Board-Folk/TIM011B2/Expansions/T2.1-VGA-RP2040/README.md

# T2.1-VGA-RP2040

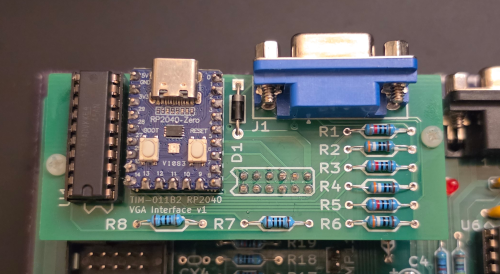
[picture p2: images/t2.1-vga-rp2040_built_small.png]
Image of TIM-011B2 v2.1 VGA Adapter built in Green


VGA Adapter for TIM-011B2 v2.1 using the RP2040 Mini. Code based on RGBI_TO_VGA by Dmitry Tsvetkov can be found on [Marko's fork for the TIM011B2](https://github.com/msolajic/RGBI_TO_VGA).

## Versions

v1 Initial version
