Board-Folk/TIM011B2/Releases/v2.2/README.md

# TIM-011B2 v2.2

04/11/2026

Image of build version 2.2 board in black with mini ps/2 module

Ceramic capacitors 5.08mm and resistors 1/4W.
CPLD and GAL by Marko Šolajić (@msolajic).
