Board-Folk/TIM011B2/Releases/v2.2/cpld/tim011video/timvideo.jpg

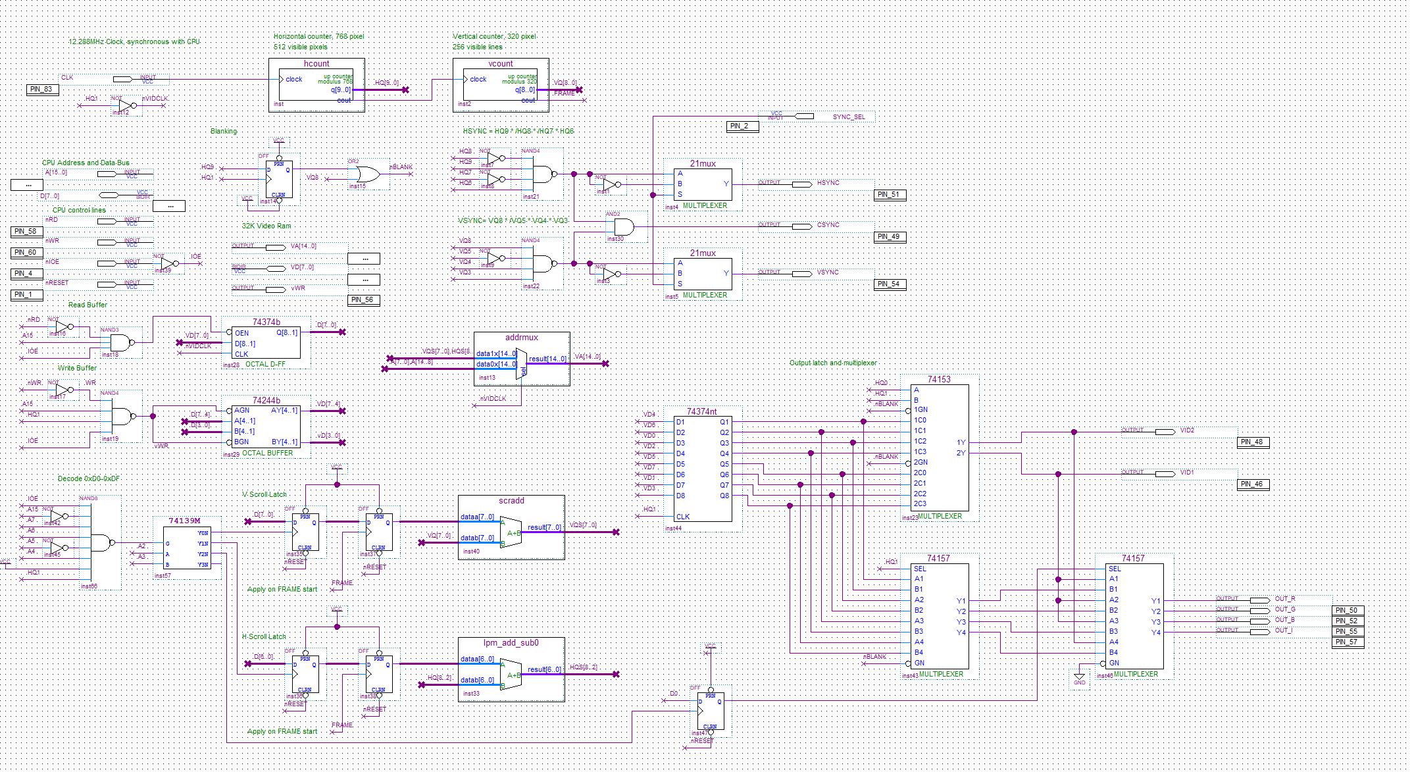
Releases/v2.2/cpld/tim011video/timvideo.jpg
