Board-Folk/TIM011B2/Releases/v2.2/Kicad/TIM-011B2.pdf

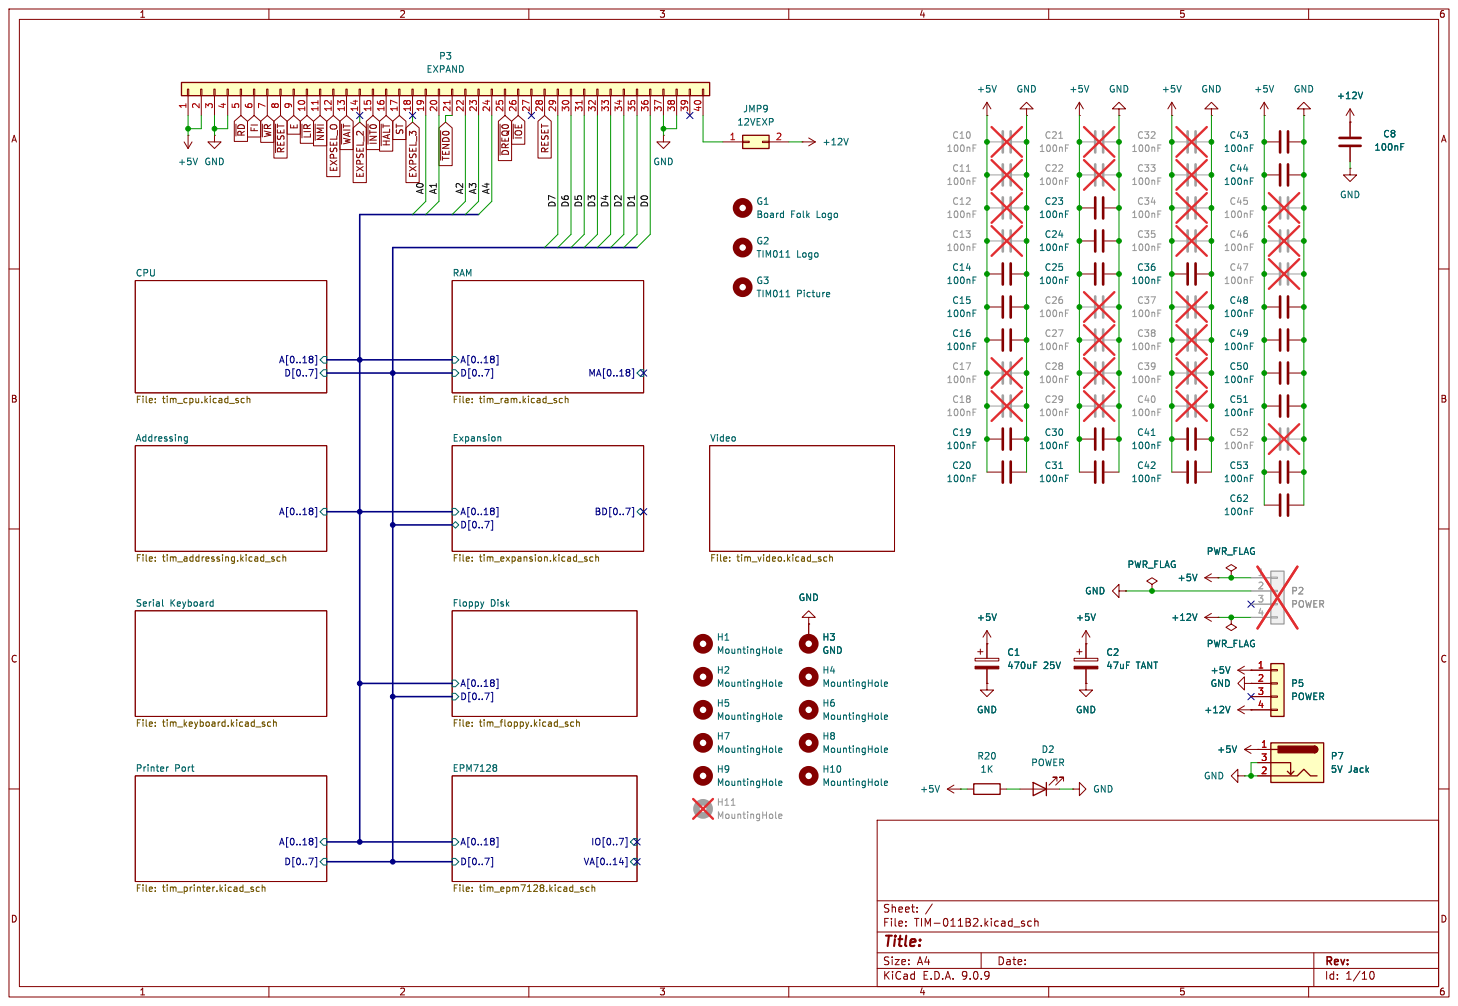
[picture p5: page 1]

100nF G3 TIM011 Picture G1 Board Folk Logo

File: tim_ram.kicad_sch Serial Keyboard File: tim_keyboard.kicad_sch

Id: 1/10 Title: File: TIM-011B2.kicad_sch Sheet: / A[0..18]

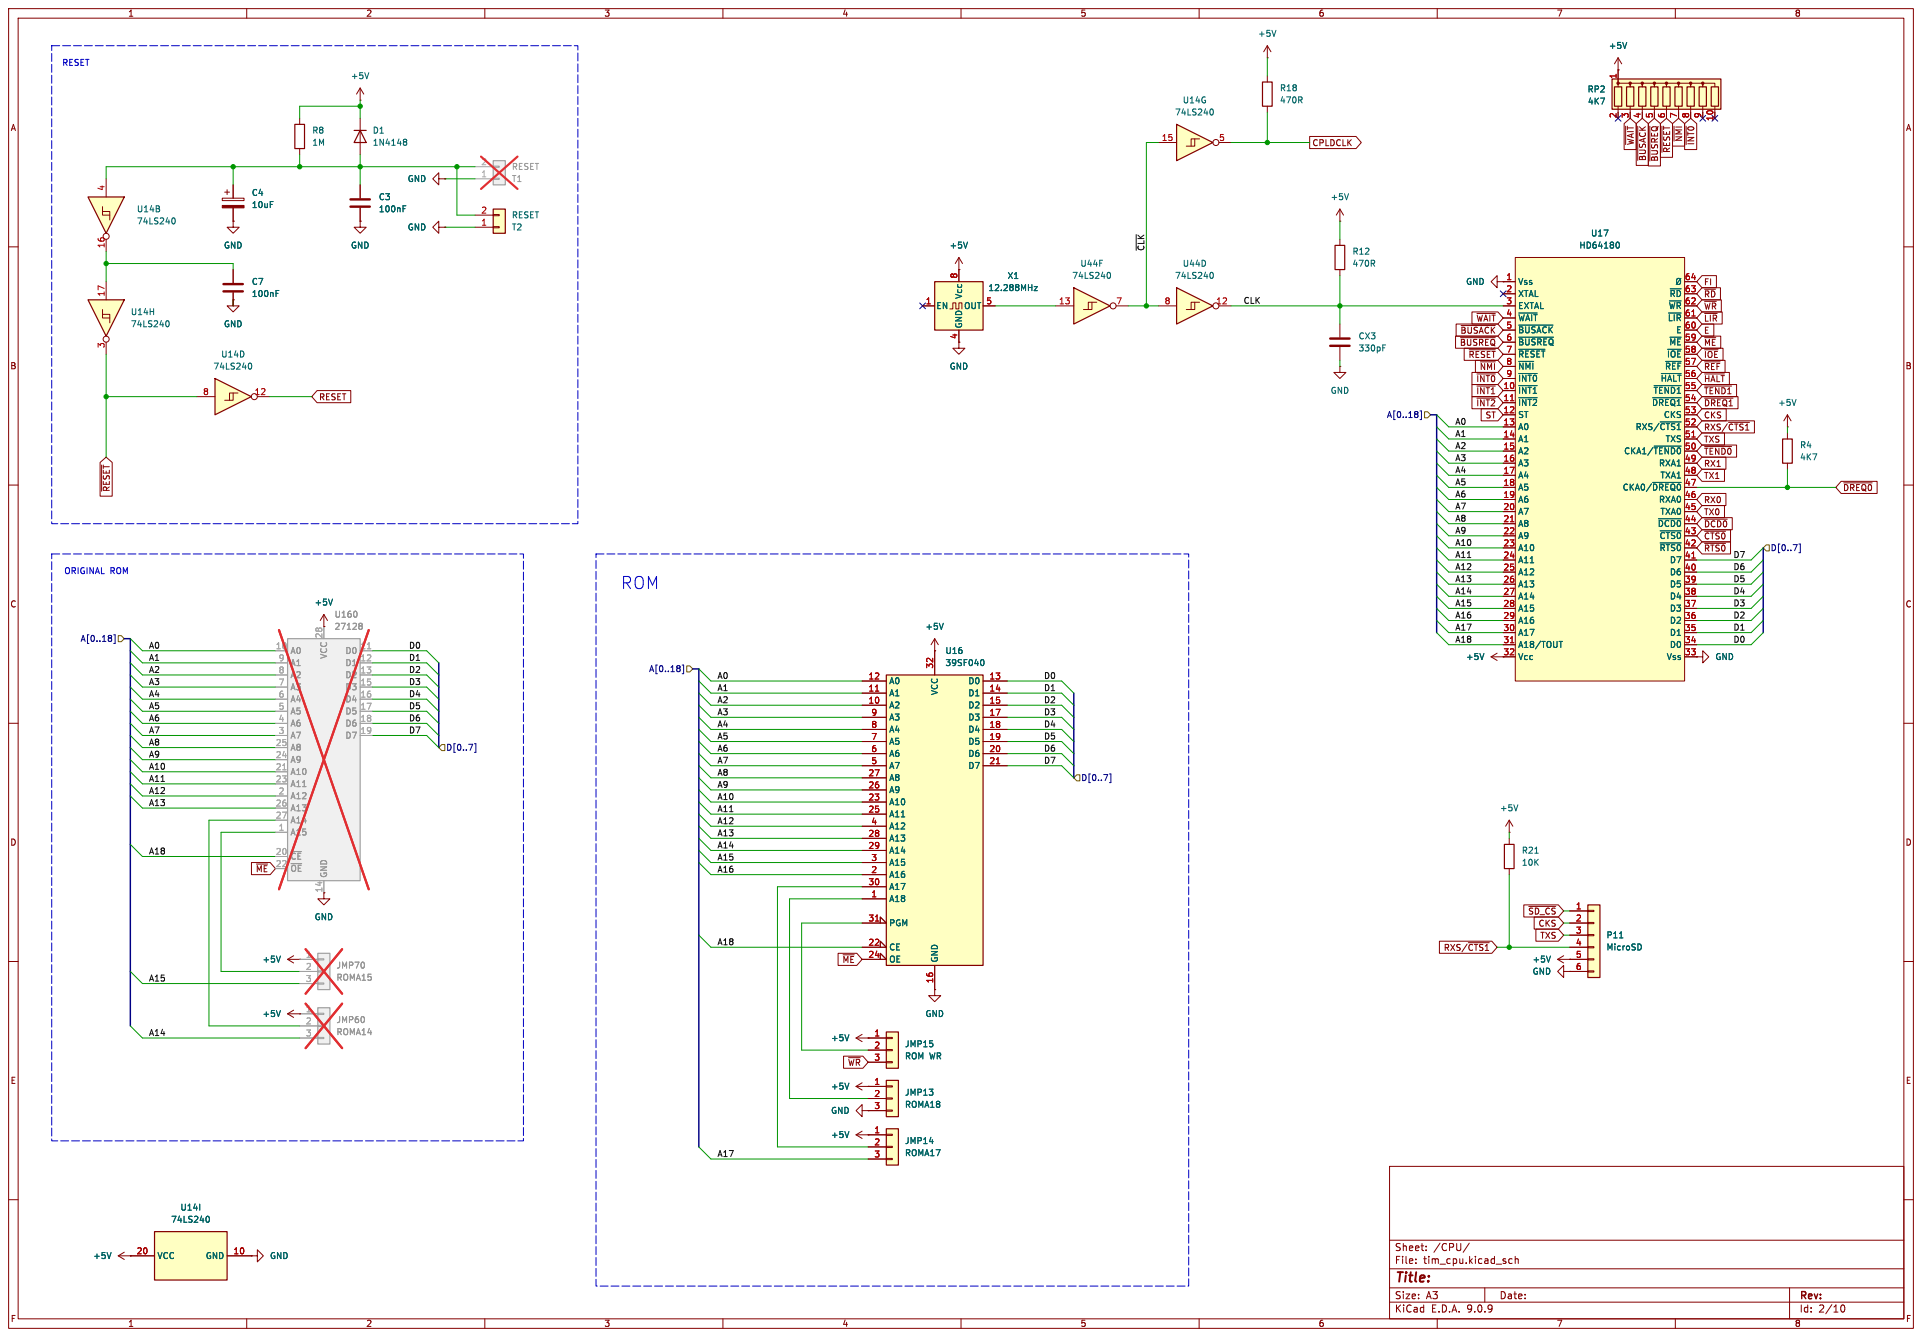
[picture p6: page 2]

64 ~{RD} 63 ~{WR} 62 ~{LIR}61 E
60 ~{ME} 59 ~{IOE} 58 ~{REF} 57 ~{HALT} 56 ~{TEND1}55 ~{DREQ1}54 CKS

Id: 2/10 Title: File: tim_cpu.kicad_sch Sheet: /CPU/ 123

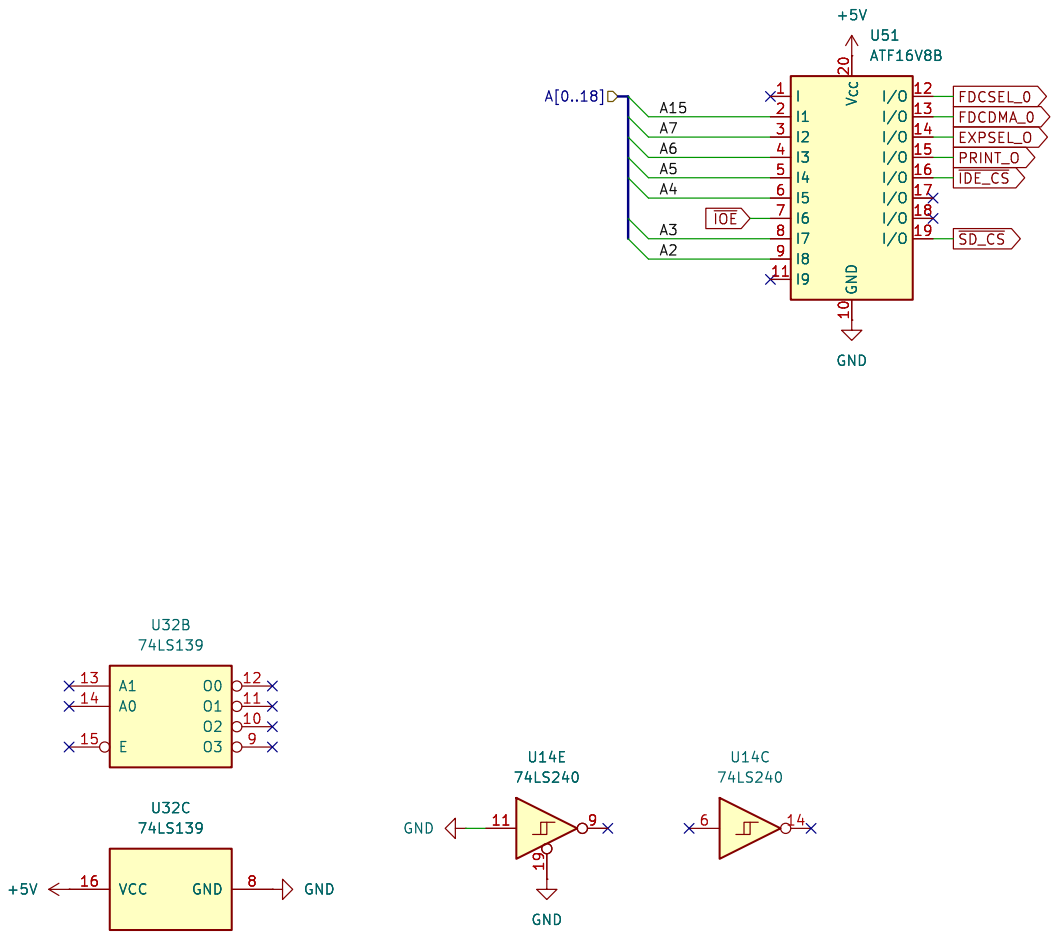
[picture p7: page 3]

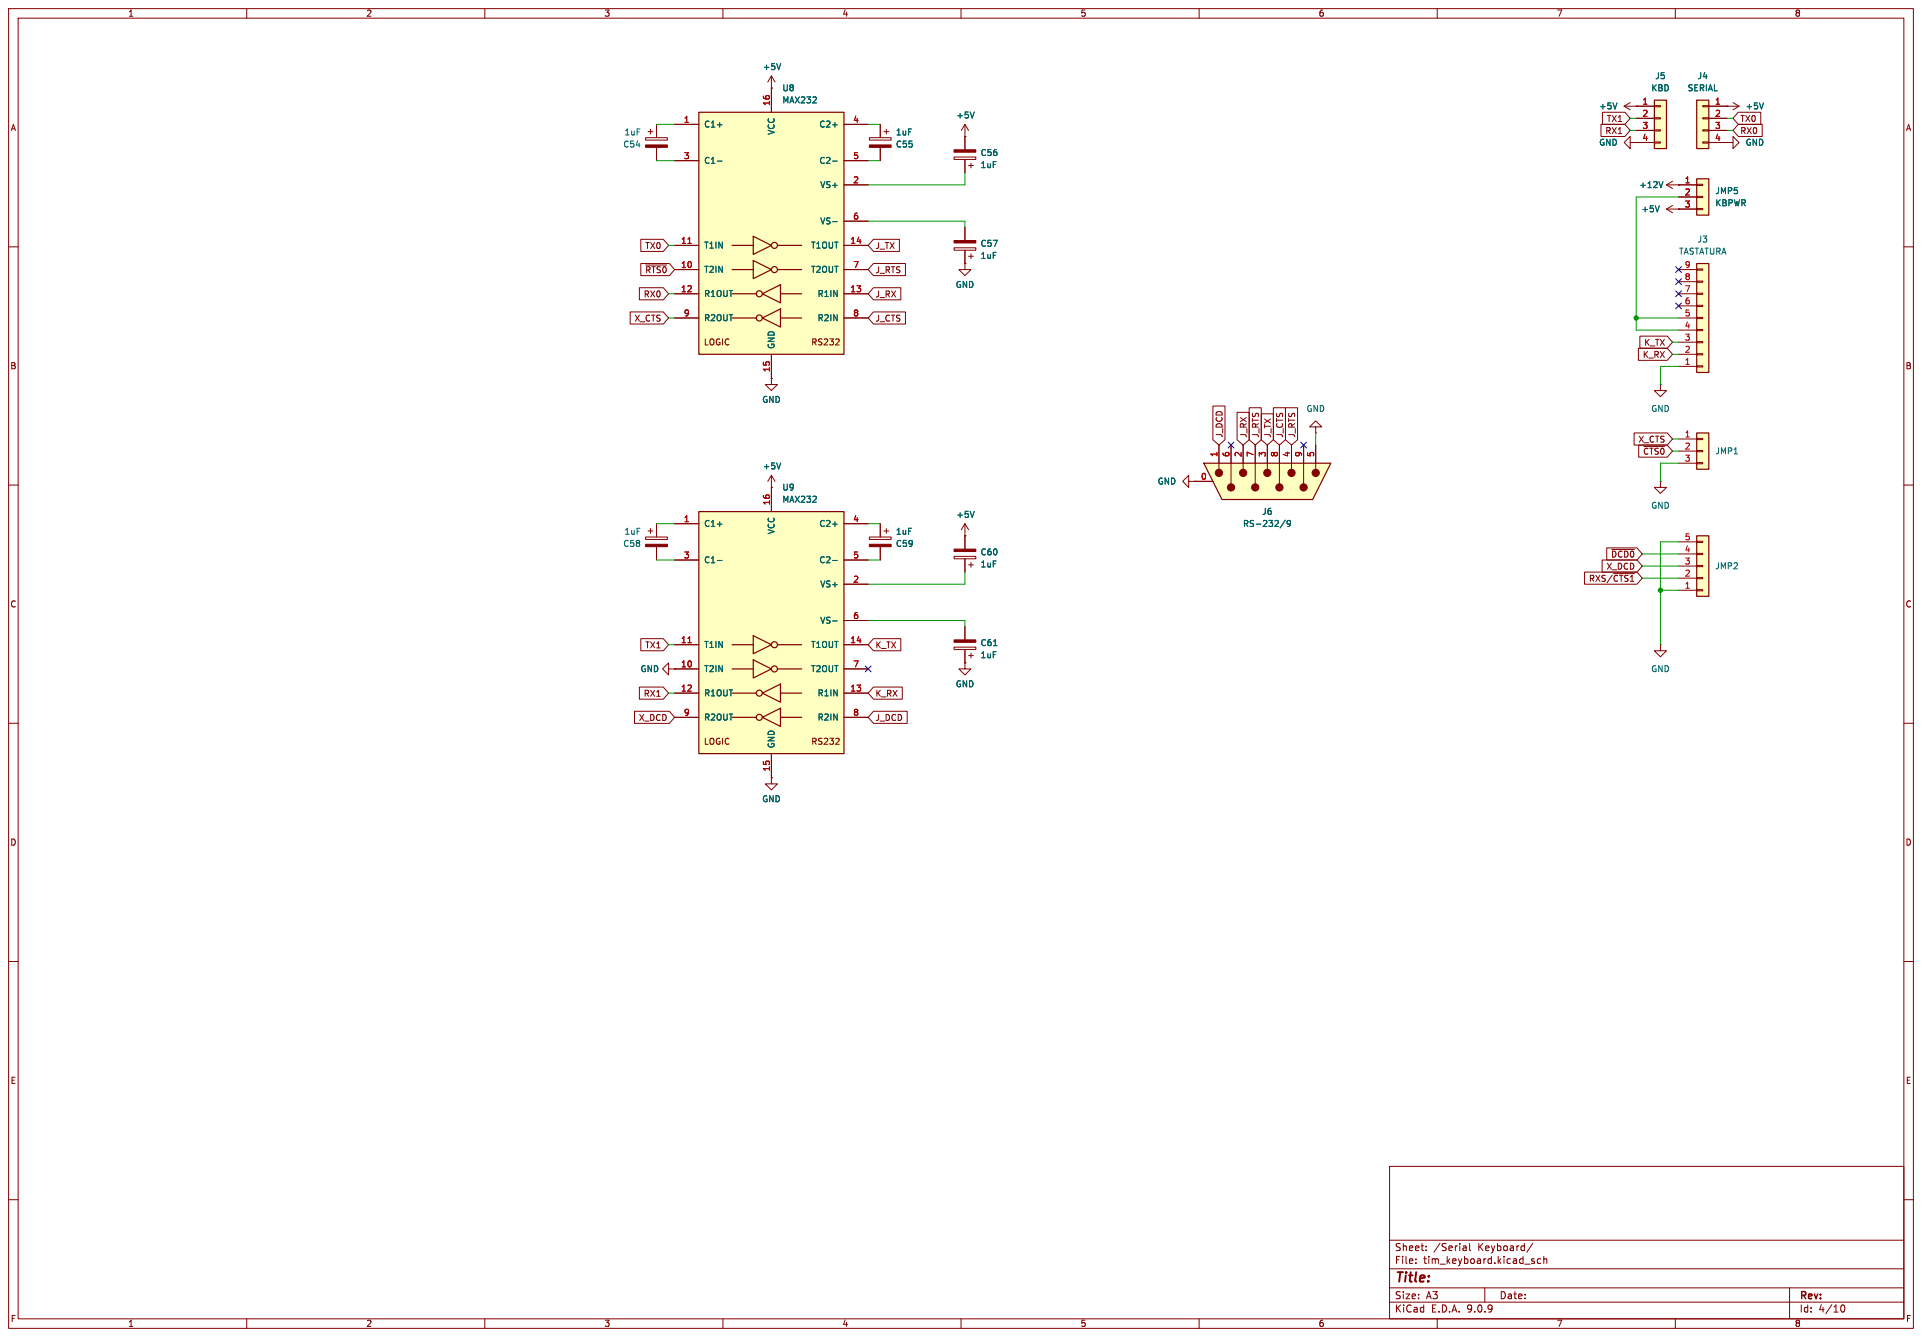
[picture p8: page 4]

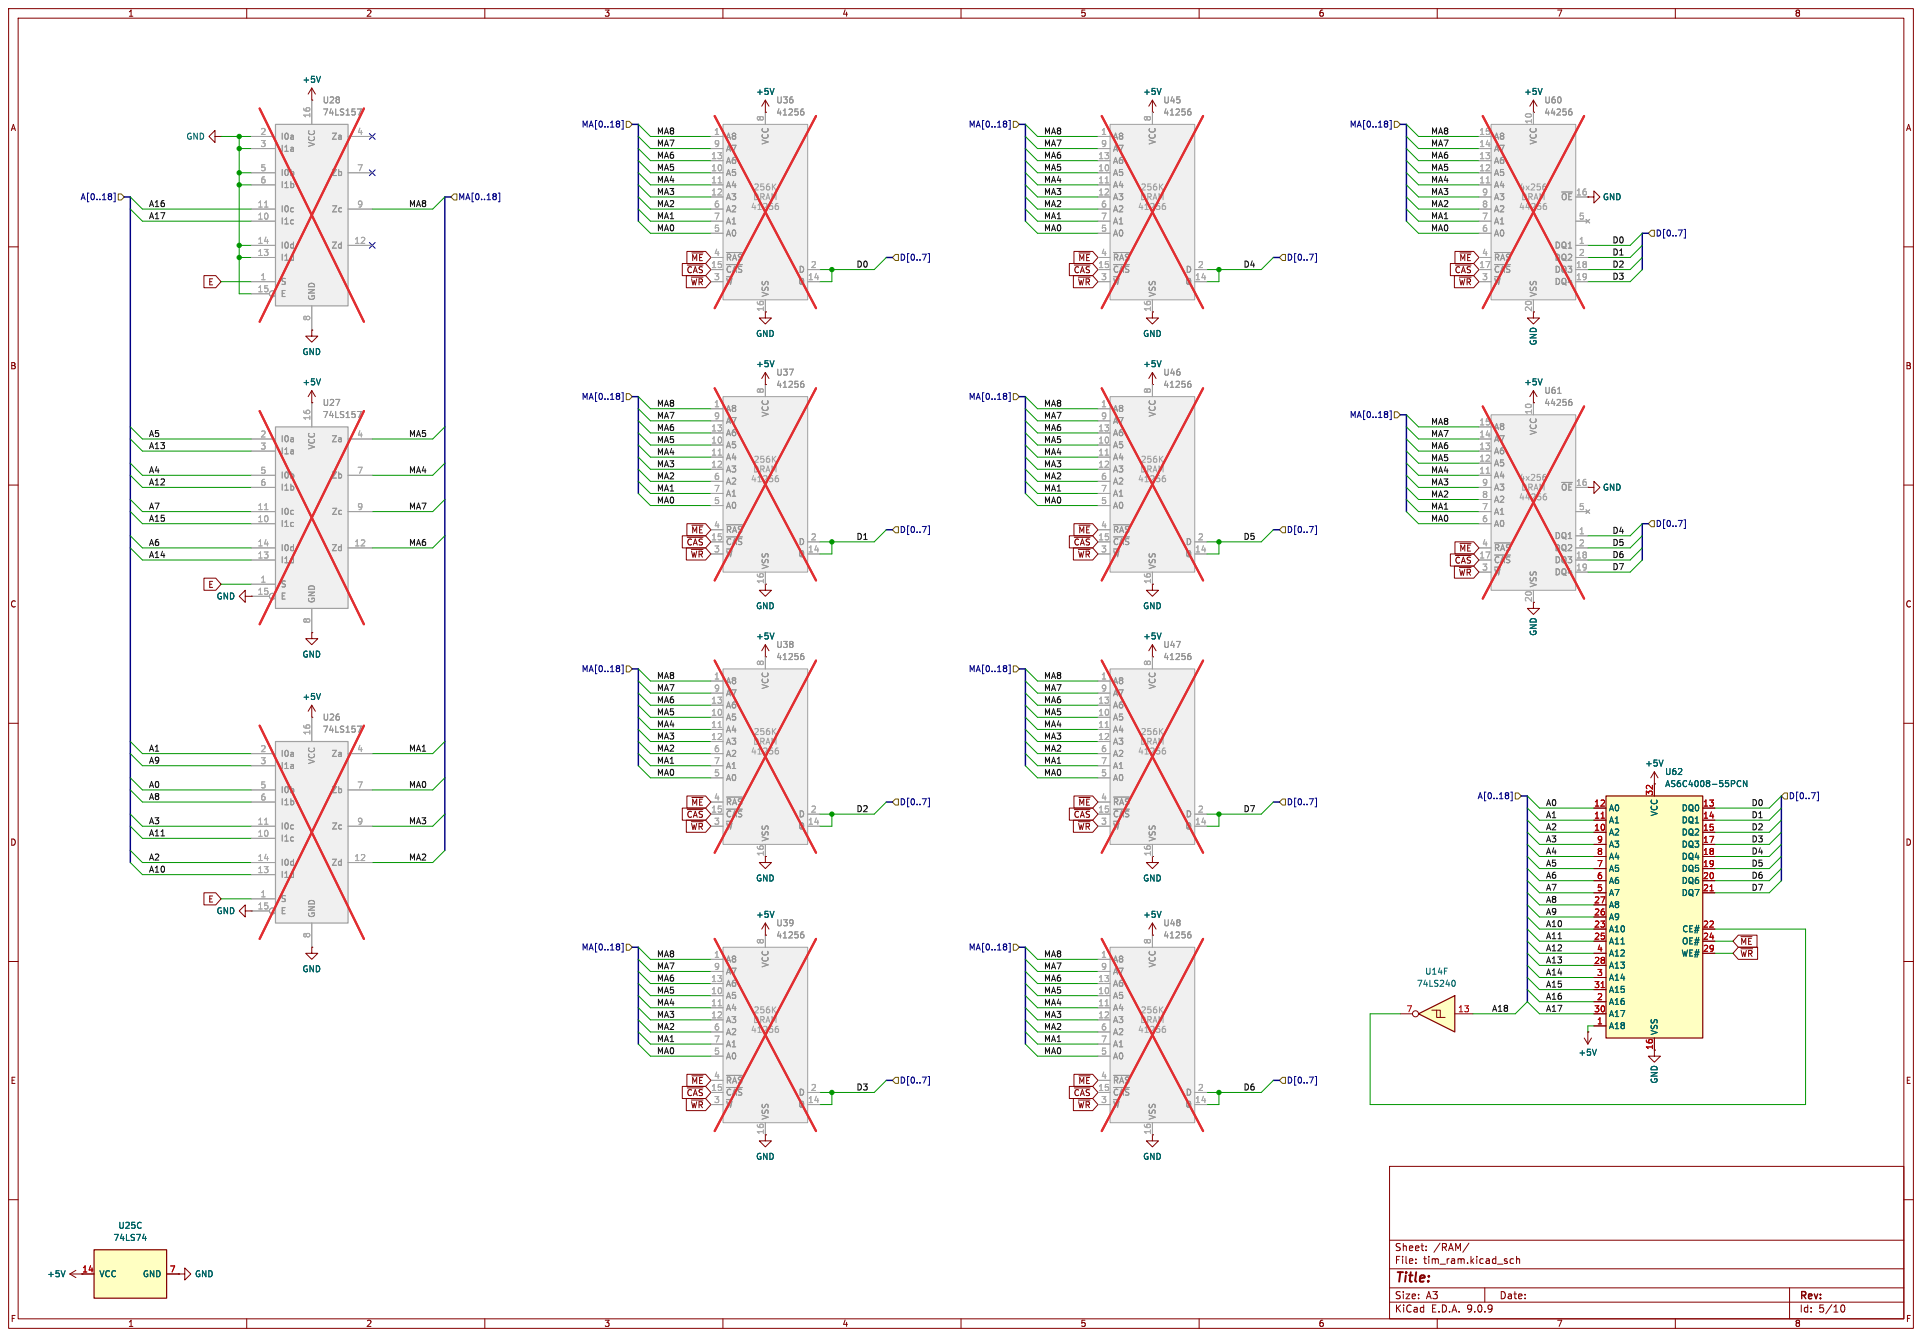
[picture p9: page 5]

Id: 5/10 Title: File: tim_ram.kicad_sch Sheet: /RAM/

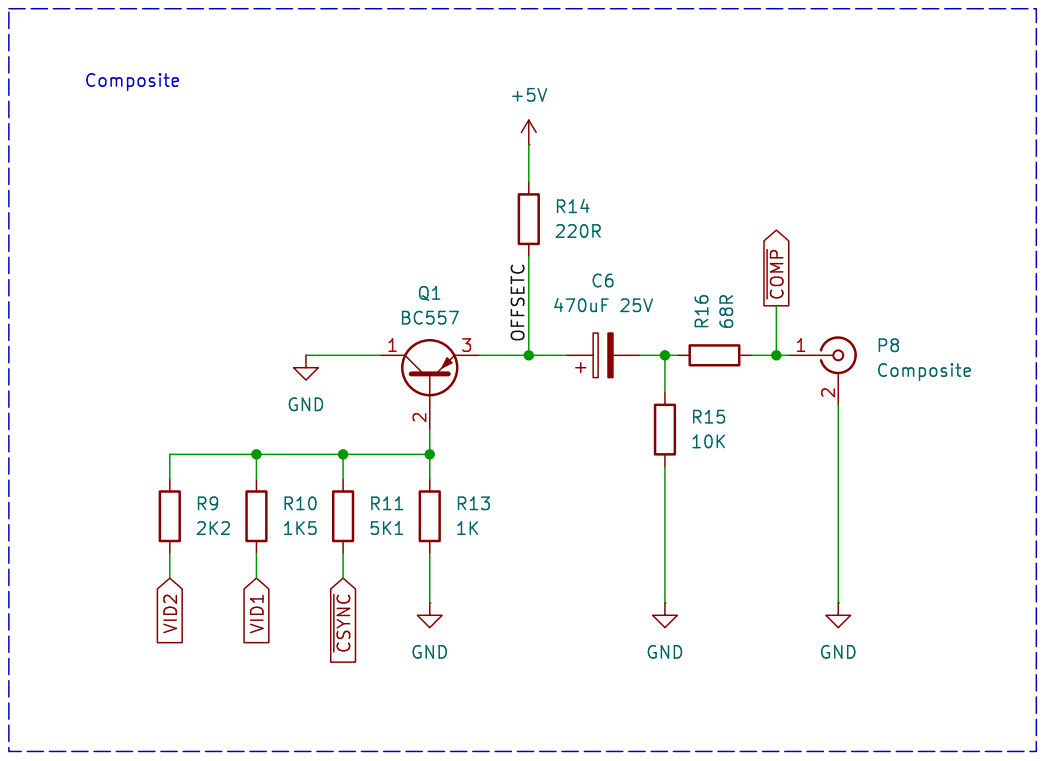
[picture p10: page 6]

2 P8Composite GND VID2 VID1 ~{CSYNC} ~{COMP} OFFSETC

Id: 6/10 Title: File: tim_video.kicad_sch Sheet: /Video/

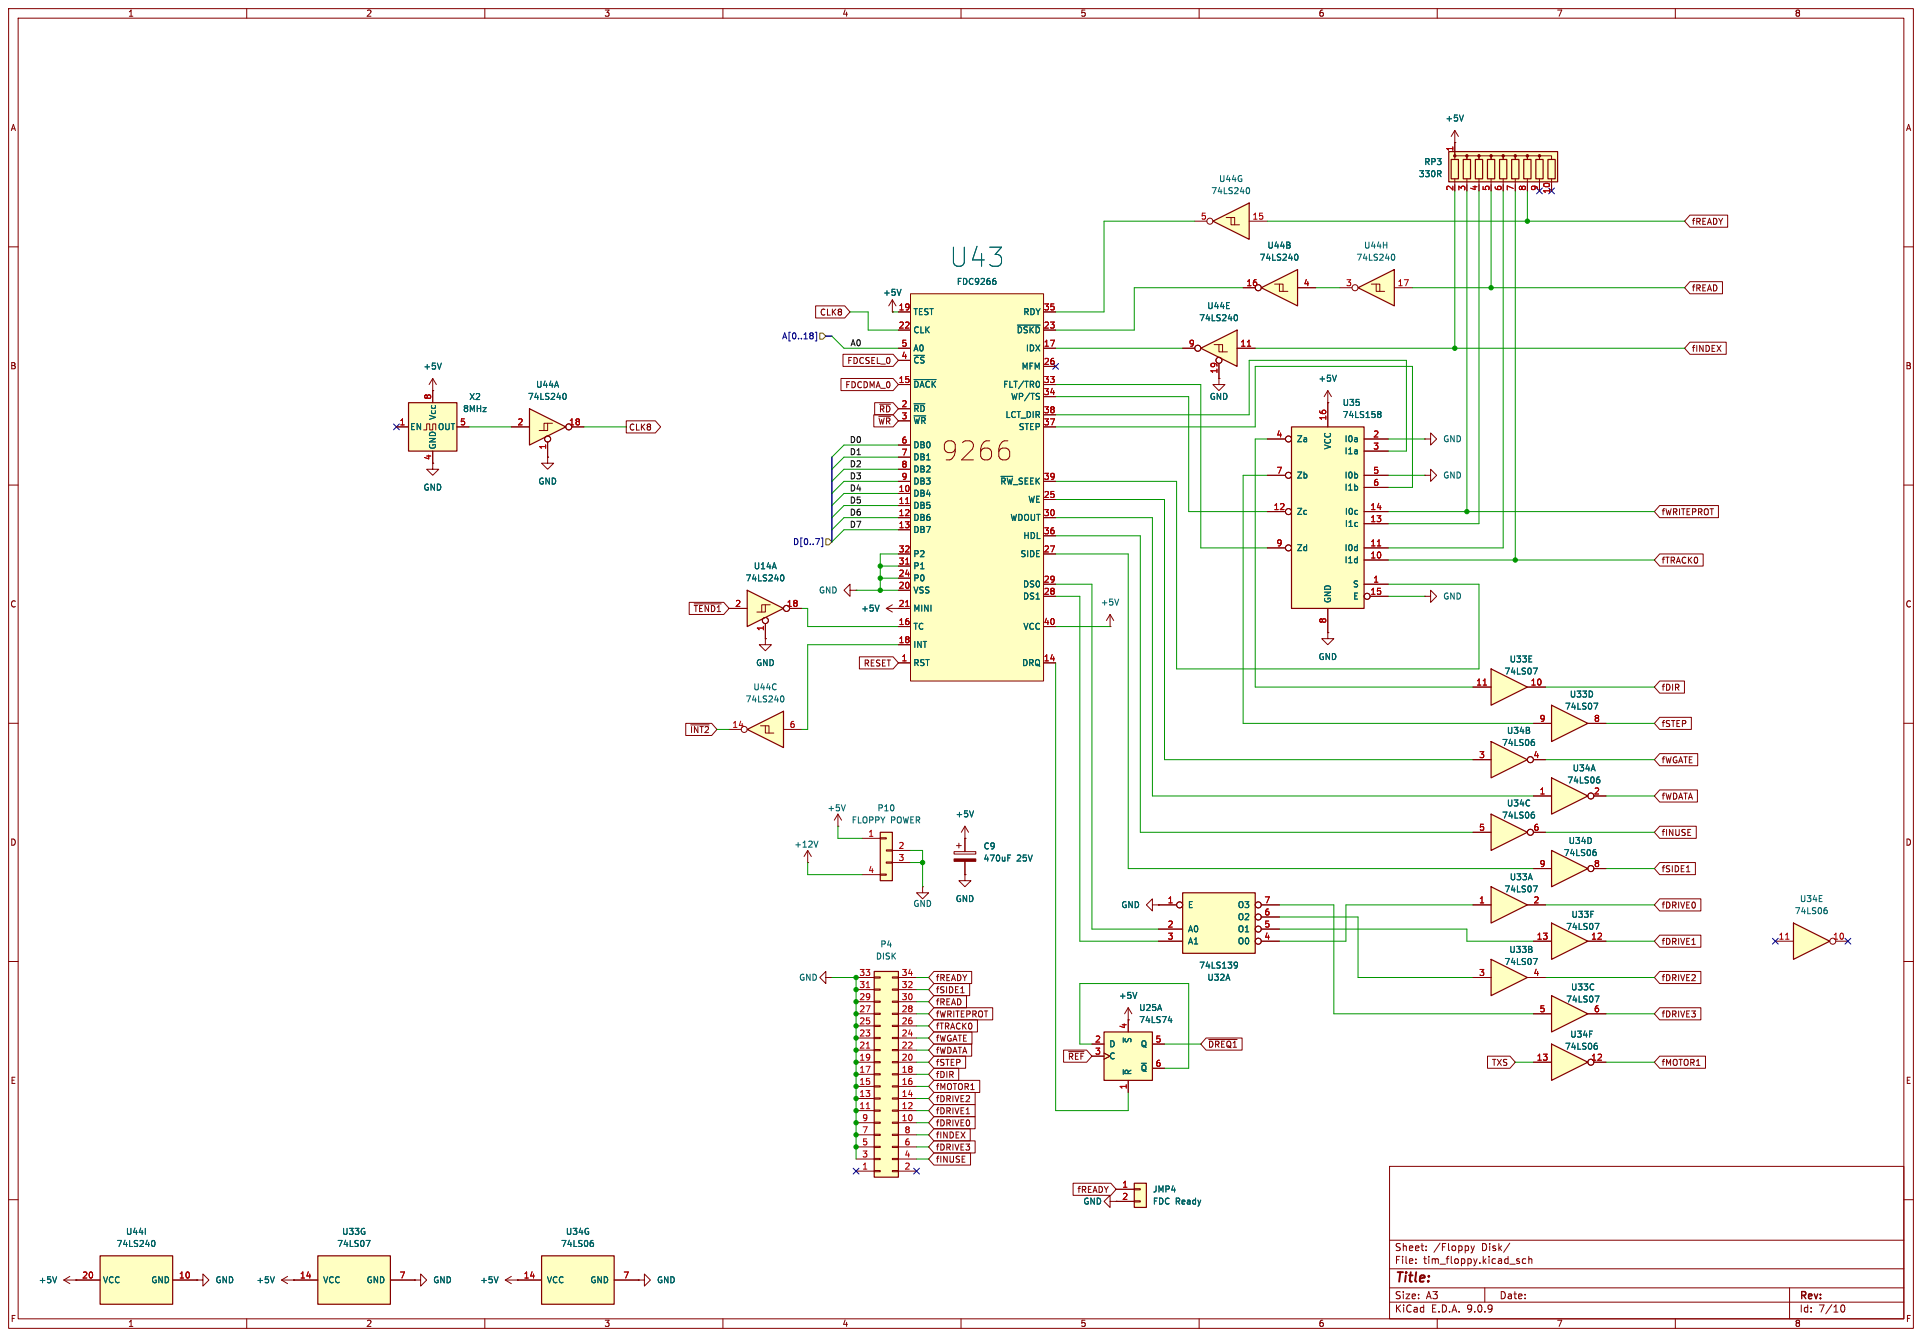
[picture p11: page 7]

LCT_DIR 38 ~{RW}_SEEK39 WE 25 WDOUT 30 HDL 36 VCC 40 DRQ 14 STEP 37 SIDE 27 DS0 29 DS1 28 U43
FDC9266 GND
TEST 19 CLK 22 A0 5 ~{CS} 4 ~{DACK} 15 ~{RD} 2 ~{WR} 3 DB0 6 DB1 7 DB2 8 DB3 9 DB4 10 DB5 11 DB6 12 DB7 13 P2 32 P1 31 P0 24 VSS 20 MINI 21 TC 16

+5V GND
LCT_DIR 38 ~{RW}_SEEK39 WE 25 WDOUT 30 HDL 36 VCC 40 DRQ 14 STEP 37 SIDE 27 DS0 29 DS1 28 GND

FDC9266 TEST 19 CLK 22 A0 5 ~{CS} 4 ~{DACK} 15 ~{RD} 2 ~{WR} 3 DB0 6 DB1 7 DB2 8 DB3 9 DB4 10 DB5 11 DB6 12 DB7 13 P2 32 P1 31 P0 24 VSS 20 MINI 21 TC 16

IDX 17 MFM 26 FLT/TR0 33 WP/TS 34

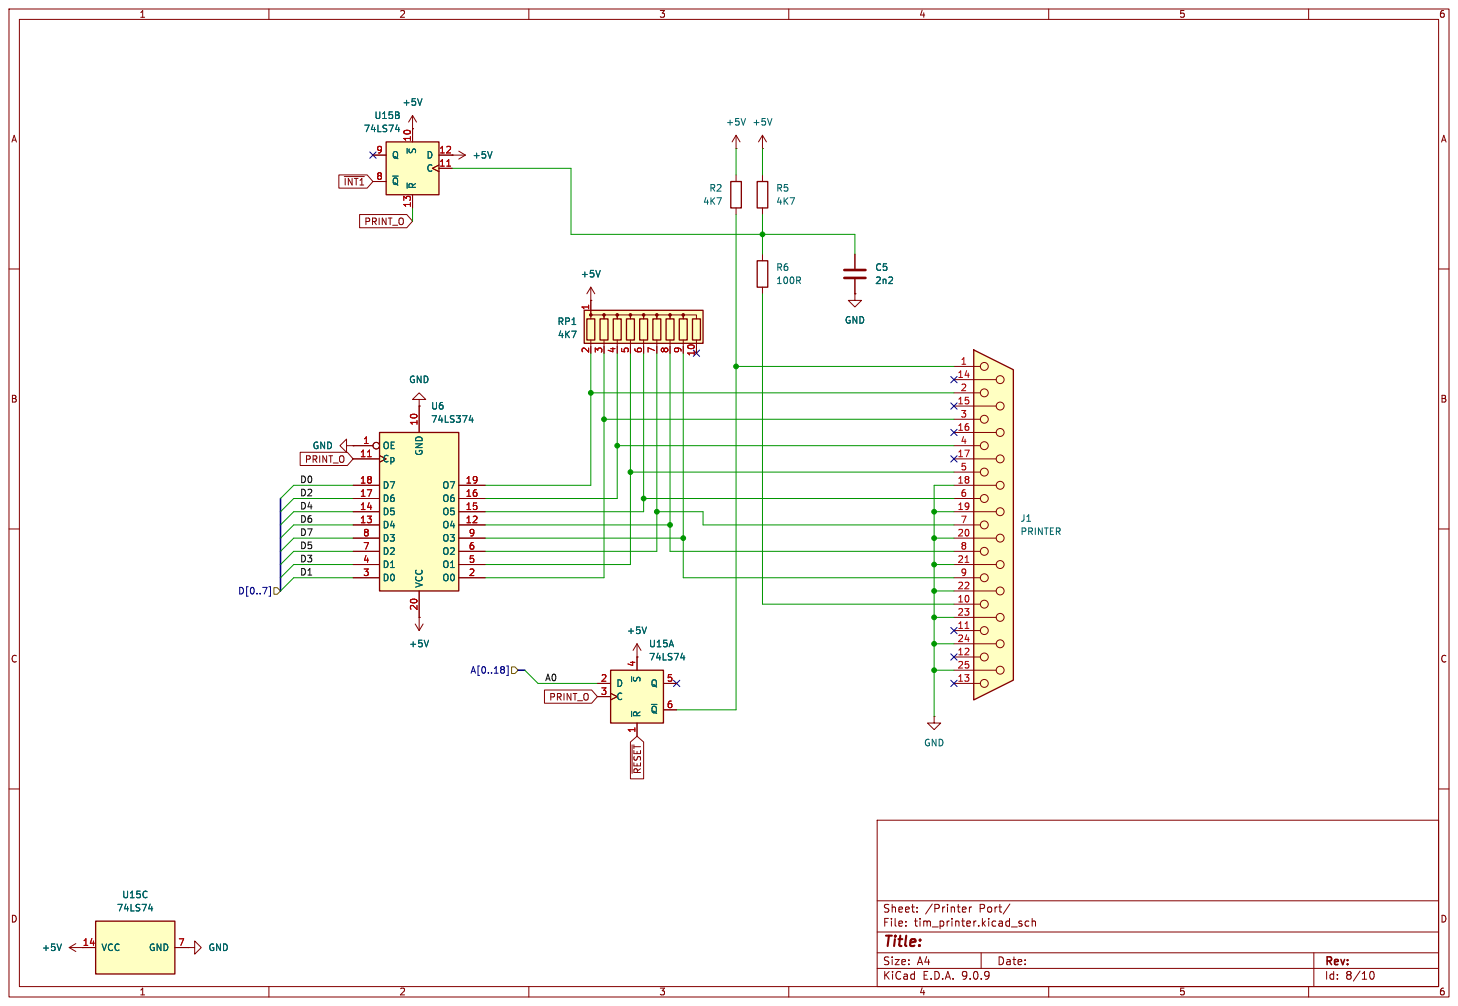
[picture p12: page 8]

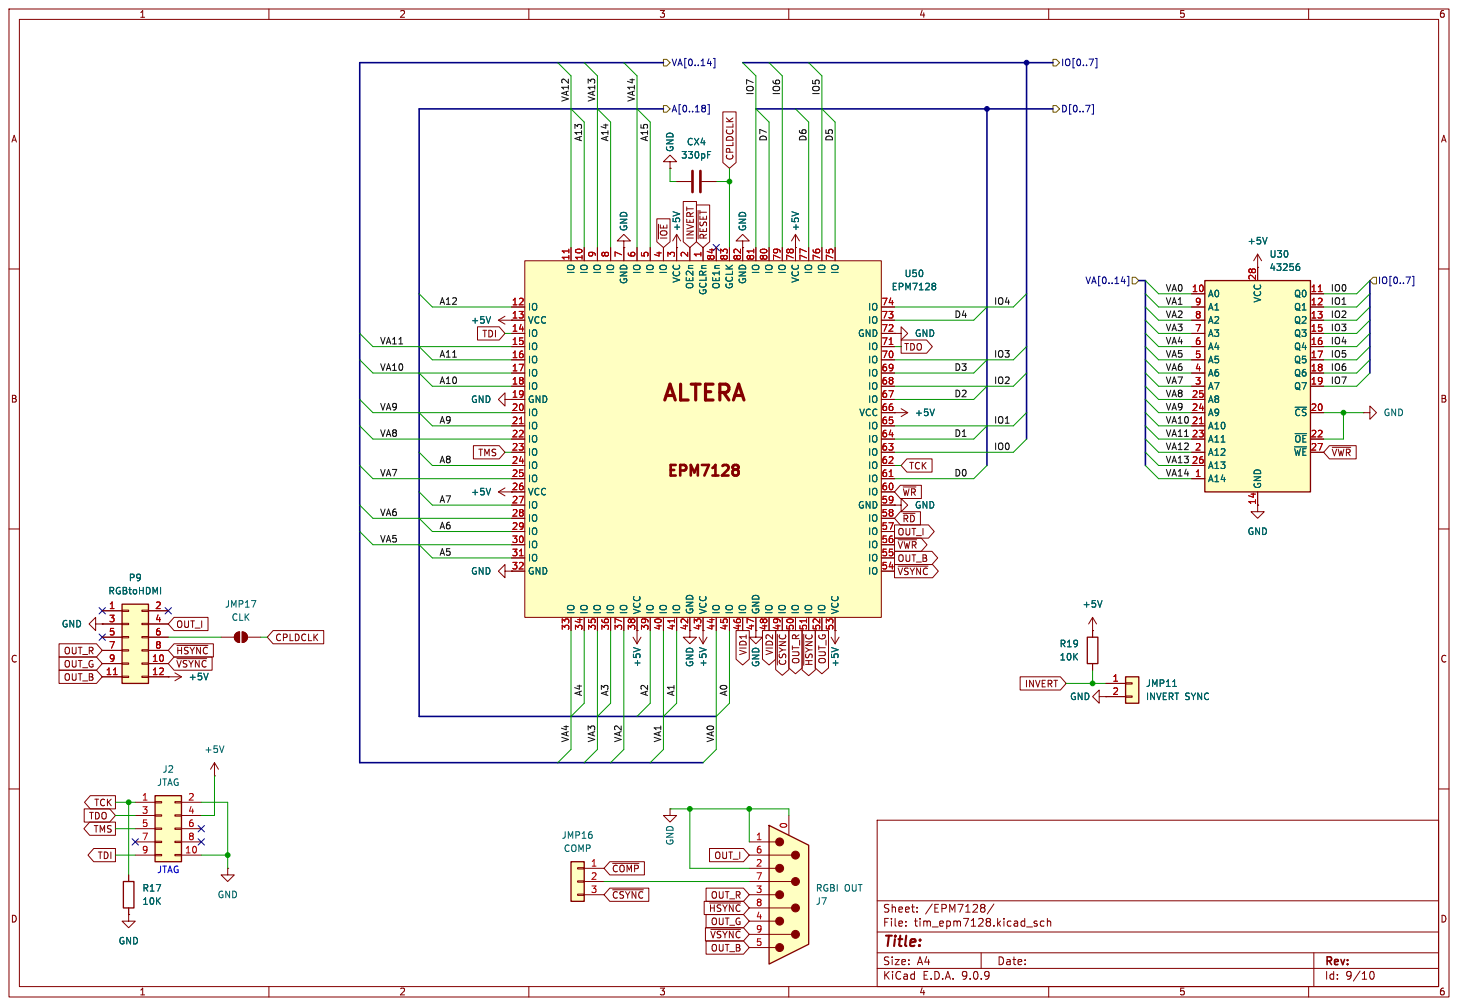
[picture p13: page 9]

INVERT SYNC 12 GND GND
TDO

Id: 9/10 Title: File: tim_epm7128.kicad_sch Sheet: /EPM7128/

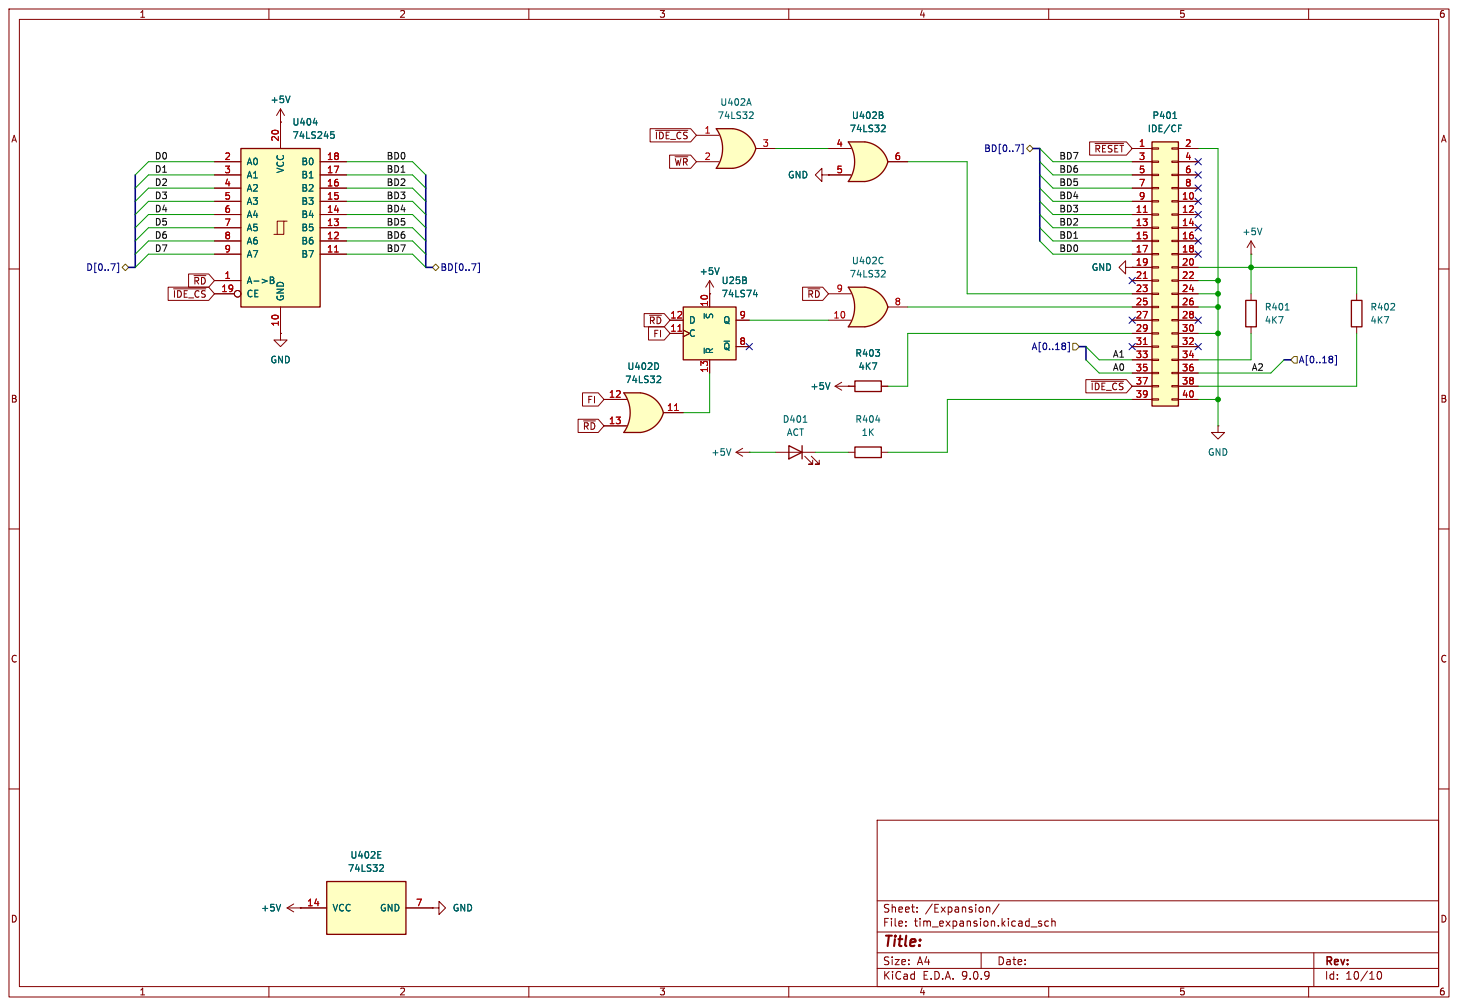
[picture p14: page 10]

~{RESET} FI FI ~{RD}

Id: 10/10 Title: File: tim_expansion.kicad_sch Sheet: /Expansion/
