Board-Folk/TIM011B2/Expansions/T2.1-VGA-RP2040/Kicad/T2.1-VGA-RP2040.kicad_pcb

## KiCad design Expansions/T2.1-VGA-RP2040/Kicad/T2.1-VGA-RP2040.kicad_pcb (2026-11-05)

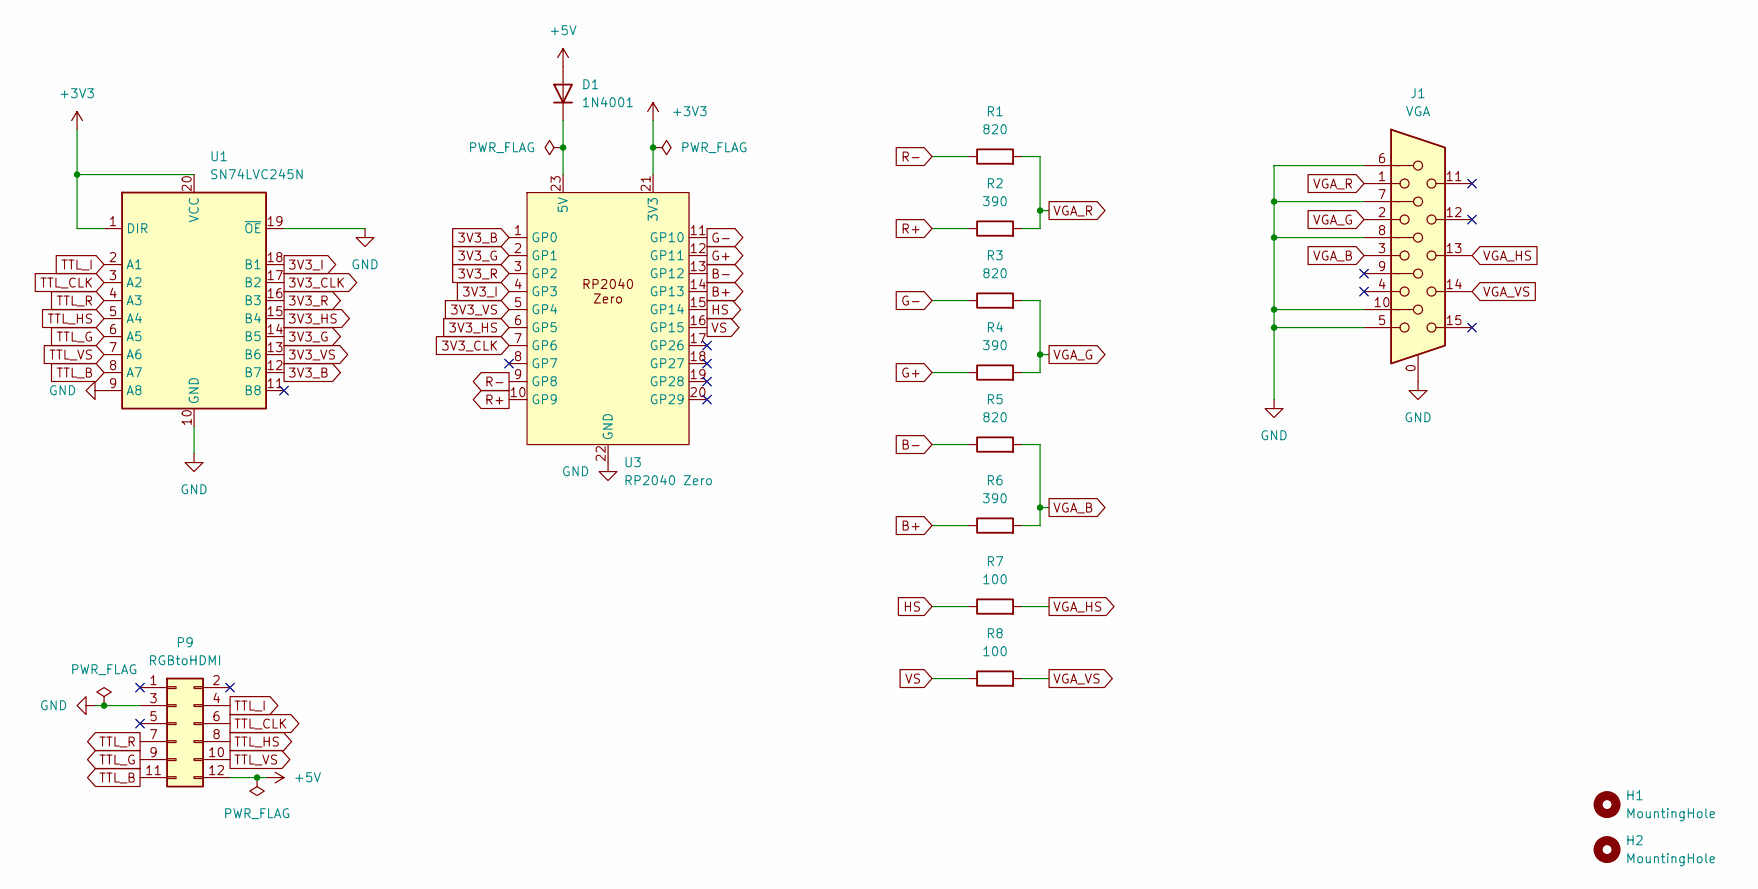
[picture p15: schematic T2.1-VGA-RP2040.kicad_sch]

Parts:
D1: 1N4001; TIM_D_DO-41_SOD81_P10.16mm_Horizontal
H1, H2: MountingHole; MountingHole_M2.5
J1: VGA; DSUB-15-HD_VGA_Short
P9: RGBtoHDMI; PinHeader_2x6_2.54mm
R1, R3, R5: 820; Resistor 12.7mm
R2, R4, R6: 390; Resistor 12.7mm
R7, R8: 100; Resistor 12.7mm
U1: SN74LVC245N; DIP-20_W7.62mm
U3: RP2040 Zero

Connections:
3V3_B: U1.12 (B7), U3.1 (GP0)
3V3_CLK: U1.17 (B2), U3.7 (GP6)
3V3_G: U1.14 (B5), U3.2 (GP1)
3V3_HS: U1.15 (B4), U3.6 (GP5)
3V3_I: U1.18 (B1), U3.4 (GP3)
3V3_R: U1.16 (B3), U3.3 (GP2)
3V3_VS: U1.13 (B6), U3.5 (GP4)
+3V3: U1.1 (DIR), U1.20 (VCC), U3.21 (3V3)
+5V: D1.2 (A), P9.12
B+: R6.1, U3.14 (GP13)
B-: R5.1, U3.13 (GP12)
G+: R4.1, U3.12 (GP11)
G-: R3.1, U3.11 (GP10)
GND: J1.0, J1.5, J1.6, J1.7, J1.8, J1.10, P9.3, U1.9 (A8), U1.10 (GND), U1.19 (~OE), U3.22 (GND)
HS: R7.1, U3.15 (GP14)
unnamed: D1.1 (K), U3.23 (5V)
R+: R2.1, U3.10 (GP9)
R-: R1.1, U3.9 (GP8)
TTL_B: P9.11, U1.8 (A7)
TTL_CLK: P9.6, U1.3 (A2)
TTL_G: P9.9, U1.6 (A5)
TTL_HS: P9.8, U1.5 (A4)
TTL_I: P9.4, U1.2 (A1)
TTL_R: P9.7, U1.4 (A3)
TTL_VS: P9.10, U1.7 (A6)
VGA_B: J1.3, R5.2, R6.2
VGA_G: J1.2, R3.2, R4.2
VGA_HS: J1.13, R7.2
VGA_R: J1.1, R1.2, R2.2
VGA_VS: J1.14, R8.2
VS: R8.1, U3.16 (GP15)

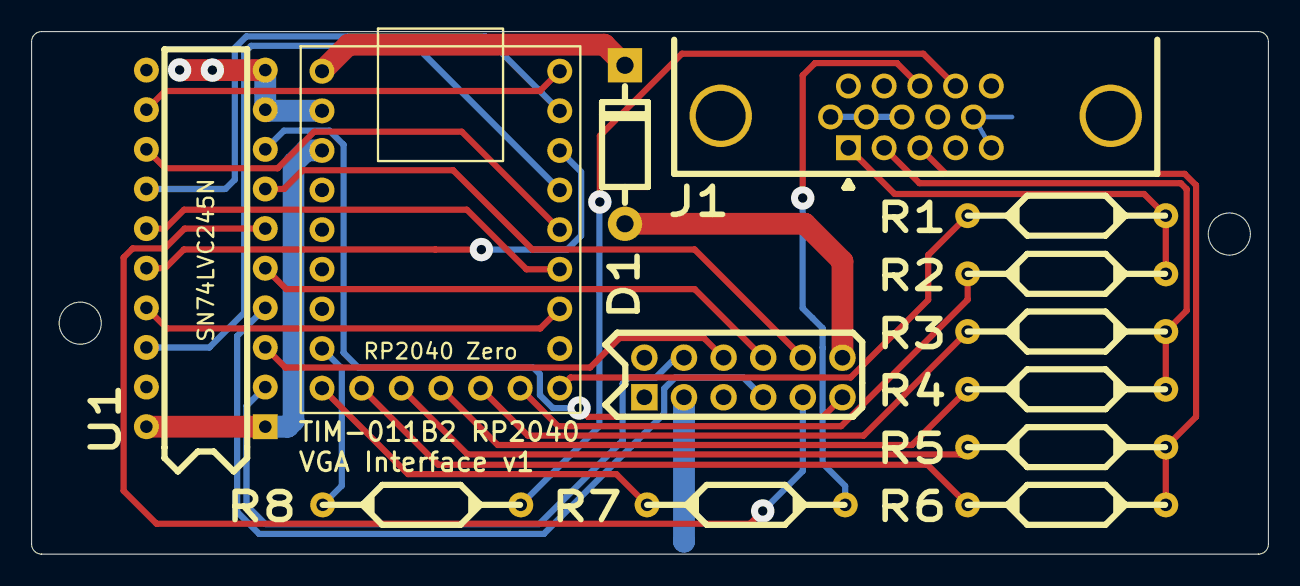
[picture p16: board T2.1-VGA-RP2040.kicad_pcb from above]

Board: 2 copper layers, 79.3 x 33.5 mm, 15 parts (0 on the bottom side), 31 nets.
