Board-Folk/TIM011B2/Releases/v2.2/Kicad/TIM-011B2.kicad_pcb

## KiCad design Releases/v2.2/Kicad/TIM-011B2.kicad_pcb (2026-11-05)

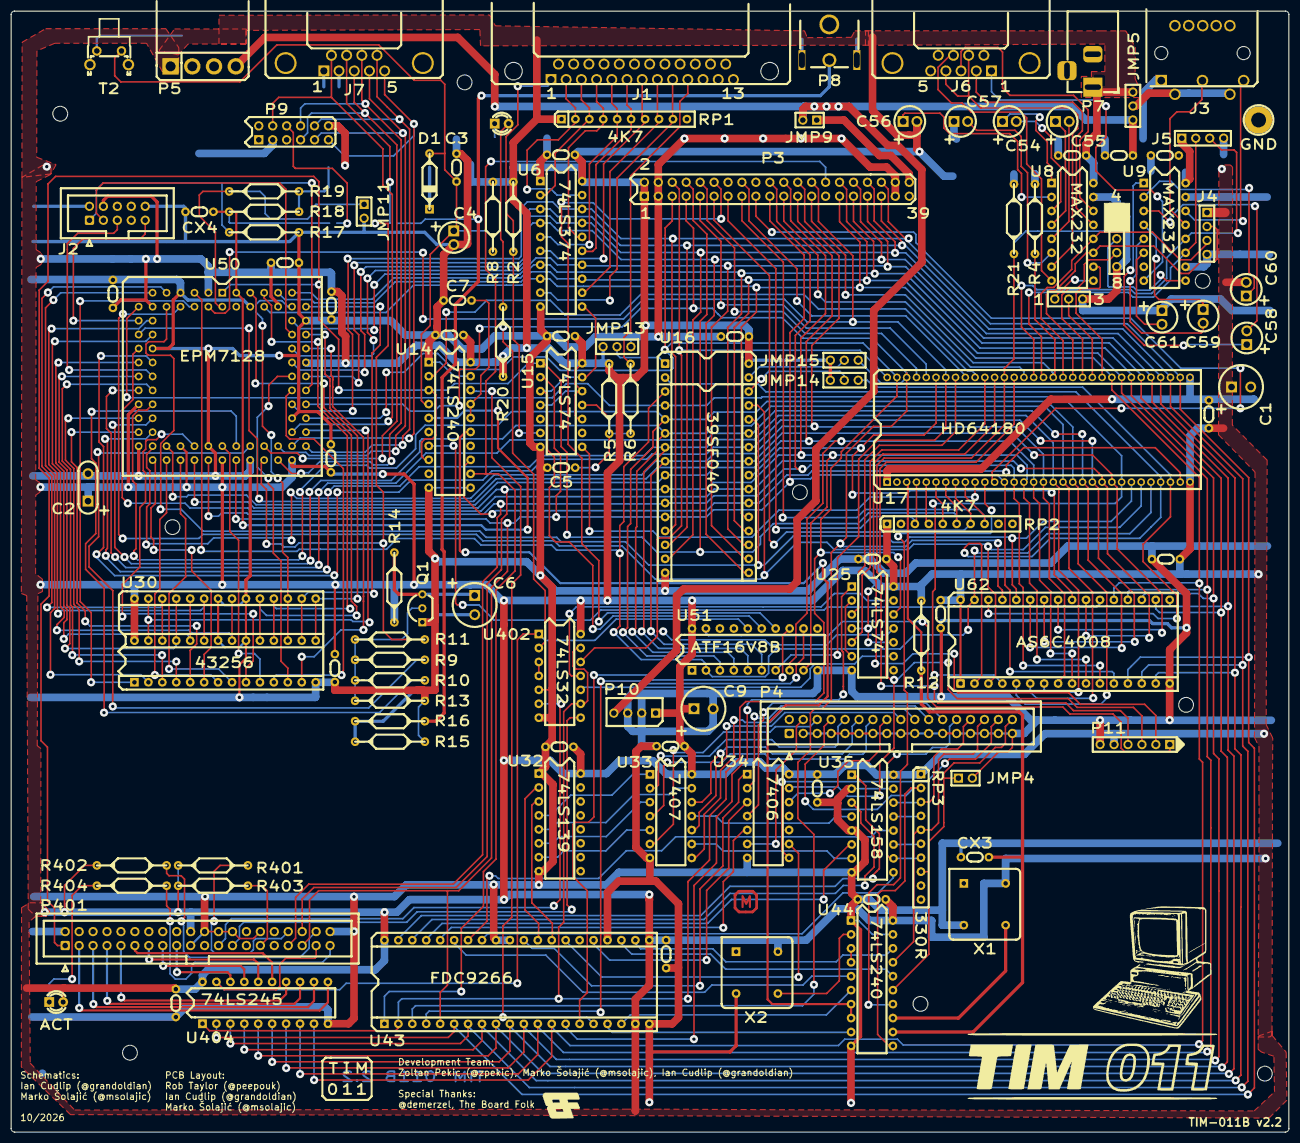
[picture p17: board TIM-011B2.kicad_pcb from above]

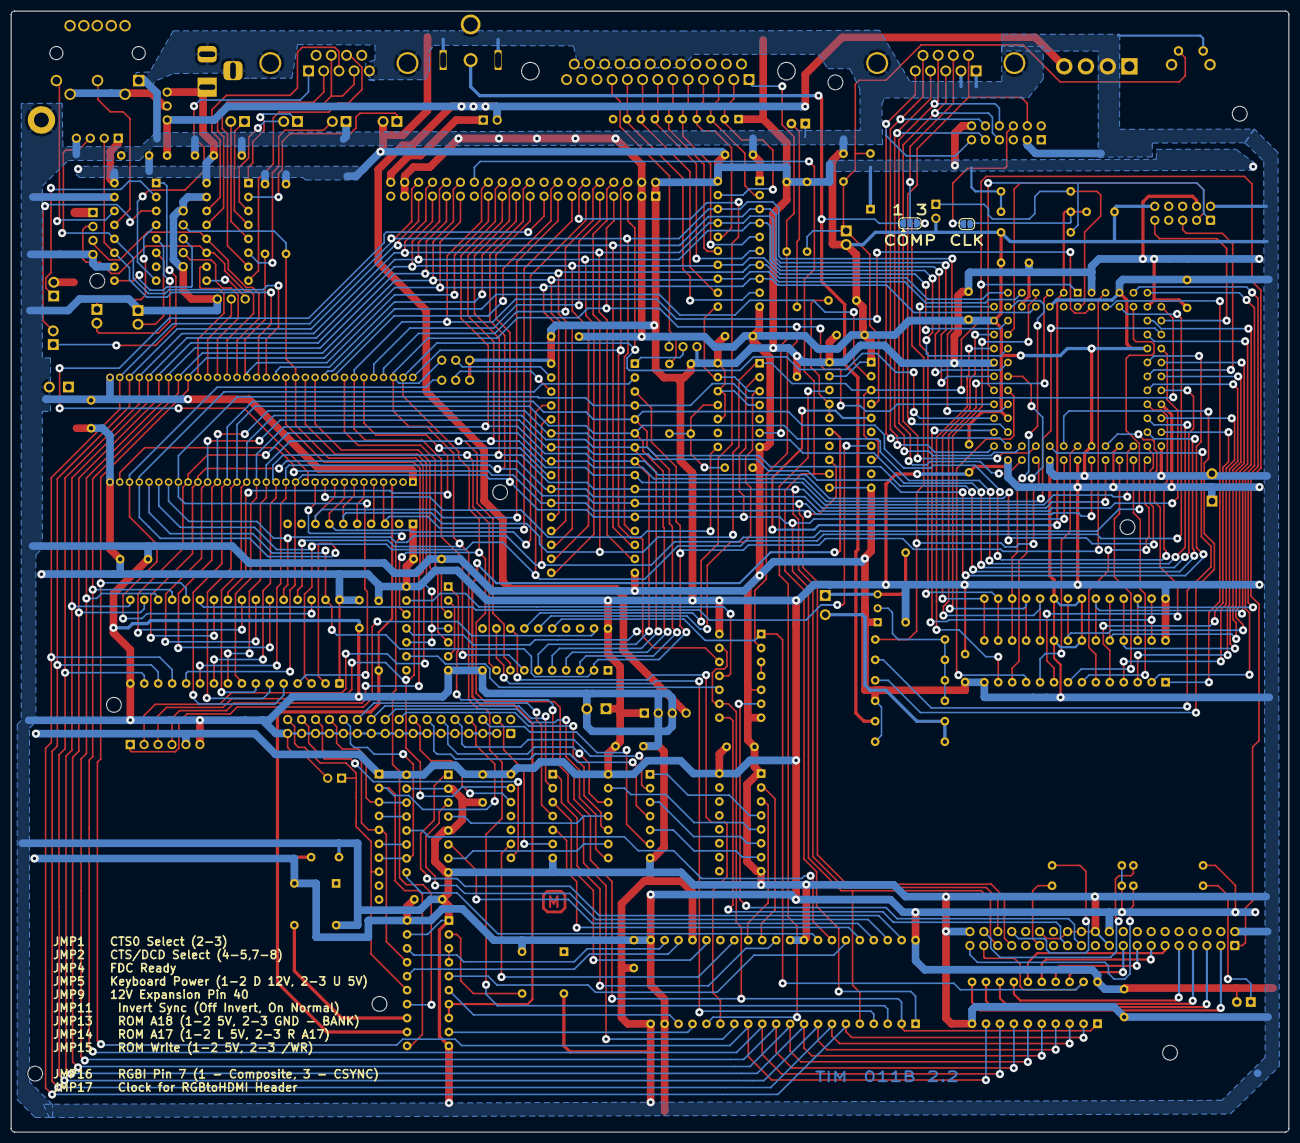
[picture p18: board TIM-011B2.kicad_pcb from below]

Board: 2 copper layers, 232.8 x 204.2 mm, 132 parts (2 on the bottom side), 221 nets.

Parts:
C1, C6, C9: 470uF 25V; Electrolytic Capacitor Radial 3.5mm
C2: 47uF TANT; Tantalum 5mm
C3, C7, C8, C14, C15, C16, C19, C20, C23, C24, C25, C30, C31, C36, C41, C42, C43, C44, C48, C49, C50, C51, C53, C62: 100nF; Ceramic Cap 5.08mm
C4: 10uF; Electrolytic Capacitor Radial
C5: 2n2; Ceramic Cap 5.08mm
C54, C55, C56, C57, C58, C59, C60, C61: 1uF; Electrolytic Capacitor Radial
CX3, CX4: 330pF; Ceramic Cap 5.08mm
D1: 1N4148; Diode 10.16mm
D2: POWER; TIM_LED_D3.0mm
D401: ACT; TIM_LED_D3.0mm
G1: Board Folk Logo; BF8
G2: TIM011 Logo; tim011logo
G3: TIM011 Picture; tim011_picture
H1, H2, H4, H5, H6, H7, H8, H9, H10: MountingHole; MountingHole_M2.5
H3: GND; TIM_MountingHole_2.7mm_Pad
J1: PRINTER
J2: JTAG; JTAG Header 2x05
J3: TASTATURA; KEYBOARD2
J4: SERIAL; PinHeader_1x04_2.54mm
J5: KBD; PinHeader_1x04_2.54mm
J6: RS-232/9; SERIAL9
J7: RGBI OUT; VIDEO9
JMP1: CTS0 Select; PinHeader_1x03 2.54mm
JMP2: CTS/DCD Select; PinHeader_1x05_2.54mm_Alt
JMP4: FDC Ready; PinHeader_1x02 2.54mm
JMP5: KBPWR; PinHeader_1x03 2.54mm
JMP9: 12VEXP; PinHeader_1x02 2.54mm
JMP11: INVERT SYNC; PinHeader_1x02 2.54mm
JMP13: ROMA18; PinHeader_1x03 2.54mm
JMP14: ROMA17; PinHeader_1x03 2.54mm
JMP15: ROM WR; PinHeader_1x03 2.54mm
JMP16: COMP; SolderJumper-3_P1.3mm_Open_RoundedPad1.0x1.5mm
JMP17: CLK; SolderJumper-2_P1.3mm_Open_RoundedPad1.0x1.5mm
P3: EXPAND; PinHeader_2x20 2.54mm
P4: DISK; FDD Header 2x17
P5: POWER; 3.96mm Header 4-Pin Edge
P7: 5V Jack; TIM_BarrelJack_Horizontal
P8: Composite; RCA2
P9: RGBtoHDMI; PinHeader_2x6_2.54mm
P10: FLOPPY POWER; PinHeader_1x04_2.54mm_Power Box
P11: MicroSD; PinHeader_1x06 2.54mm
P401: IDE/CF; IDE Header 2x20
Q1: BC557; TO-92_Inline_Wide
R2, R4, R5, R401, R402, R403: 4K7; Resistor 12.7mm
R6: 100R; Resistor 12.7mm
R8: 1M; Resistor 12.7mm
R9: 2K2; Resistor 12.7mm
R10: 1K5; Resistor 12.7mm
R11: 5K1; Resistor 12.7mm
R12, R18: 470R; Resistor 12.7mm
R13, R20, R404: 1K; Resistor 12.7mm
R14: 220R; Resistor 12.7mm
R15, R17, R19, R21: 10K; Resistor 12.7mm
R16: 68R; Resistor 12.7mm
RP1, RP2: 4K7; R_Array_SIP10
RP3: 330R; R_Array_SIP10
T2: RESET; New Reset
U6: 74LS374; DIP-20_W7.62mm
U8, U9: MAX232; DIP-16_W7.62mm
U14, U44: 74LS240; DIP-20_W7.62mm
U15, U25: 74LS74; DIP-14_W7.62mm
U16: 39SF040; DIP-32_W15.24mm_Dual
U17: HD64180; DIP-64_1.78mm Pitch_Socket
U30: 43256; DIP-28_Dual_Socket
U32: 74LS139; DIP-16_W7.62mm
U33: 74LS07; DIP-14_W7.62mm
U34: 74LS06; DIP-14_W7.62mm
U35: 74LS158; DIP-16_W7.62mm
U43: FDC9266; DIP-40_W15.24mm_Socket
U50: EPM7128; PLCC-84_THT-Socket
U51: ATF16V8B; DIP-20_W7.62mm
U62: AS6C4008-55PCN; DIP-32_W15.24mm
U402: 74LS32; DIP-14_W7.62mm
U404: 74LS245; DIP-20_W7.62mm
X1: 12.288MHz; TIM_Oscillator_DIP-8
X2: 8MHz; TIM_Oscillator_DIP-8

Connections:
+5V: C1.1, C2.1, C9.1, C14.1, C15.1, C16.1, C19.1, C20.1, C23.1, C24.1, C25.1, C30.1, C31.1, C36.1, C41.1, C42.1, C43.1, C44.1, C48.1, C49.1, C50.1, C51.1, C53.1, C56.2, C60.2, C62.1, D1.1 (K), D401.2 (A), J2.4, J4.1, J5.1, JMP5.3, JMP13.1, JMP14.1, JMP15.1, P3.1, P3.2, P5.1, P7.1, P9.12, P10.1, P11.5, P401.20, R2.1, R4.1, R5.1, R8.1, R12.1, R14.1, R18.1, R19.2, R20.1, R21.1, R401.1, R402.1, R403.1, RP1.1 (common), RP2.1 (common), RP3.1 (common), U6.20 (VCC), U8.16 (VCC), U9.16 (VCC), U14.20 (VCC), U15.4 (~S), U15.10 (~S), U15.12 (D), U15.14 (VCC), U16.32 (VCC), U17.32 (Vcc), U25.4 (~S), U25.10 (~S), U25.14 (VCC), U30.28 (VCC), U32.16 (VCC), U33.14 (VCC), U34.14 (VCC), U35.16 (VCC), U43.19 (TEST), U43.21 (MINI), U43.40 (VCC), U44.20 (VCC), U50.3 (VCC), U50.13 (VCC), U50.26 (VCC), U50.38 (VCC), U50.43 (VCC), U50.53 (VCC), U50.66 (VCC), U50.78 (VCC), U51.20 (V_{CC}), U62.1 (A18), U62.32 (VCC), U402.14 (VCC), U404.20 (VCC), X1.8 (Vcc), X2.8 (Vcc)
+12V: C8.1, JMP5.1, JMP9.2, P5.4, P10.4
/Addressing/A0: P3.19, P401.35, U15.2 (D), U16.12 (A0), U17.13 (A0), U43.5 (A0), U50.45 (IO), U62.12 (A0)
/Addressing/A1: P3.20, P401.33, U16.11 (A1), U17.14 (A1), U50.41 (IO), U62.11 (A1)
/Addressing/A2: P3.22, P401.36, U16.10 (A2), U17.15 (A2), U50.39 (IO), U51.9 (I8), U62.10 (A2)
/Addressing/A3: P3.23, U16.9 (A3), U17.16 (A3), U50.36 (IO), U51.8 (I7), U62.9 (A3)
/Addressing/A4: P3.24, U16.8 (A4), U17.17 (A4), U50.34 (IO), U51.6 (I5), U62.8 (A4)
/Addressing/A5: U16.7 (A5), U17.18 (A5), U50.31 (IO), U51.5 (I4), U62.7 (A5)
/Addressing/A6: U16.6 (A6), U17.19 (A6), U50.29 (IO), U51.4 (I3), U62.6 (A6)
/Addressing/A7: U16.5 (A7), U17.20 (A7), U50.27 (IO), U51.3 (I2), U62.5 (A7)
/Addressing/A8: U16.27 (A8), U17.21 (A8), U50.24 (IO), U62.27 (A8)
/Addressing/A9: U16.26 (A9), U17.22 (A9), U50.21 (IO), U62.26 (A9)
/Addressing/A10: U16.23 (A10), U17.23 (A10), U50.18 (IO), U62.23 (A10)
/Addressing/A11: U16.25 (A11), U17.24 (A11), U50.16 (IO), U62.25 (A11)
/Addressing/A12: U16.4 (A12), U17.25 (A12), U50.12 (IO), U62.4 (A12)
/Addressing/A13: U16.28 (A13), U17.26 (A13), U50.10 (IO), U62.28 (A13)
/Addressing/A14: U16.29 (A14), U17.27 (A14), U50.8 (IO), U62.3 (A14)
/Addressing/A15: U16.3 (A15), U17.28 (A15), U50.5 (IO), U51.2 (I1), U62.31 (A15)
/Addressing/A16: U16.2 (A16), U17.29 (A16), U62.2 (A16)
/Addressing/A17: JMP14.3, U17.30 (A17), U62.30 (A17)
/Addressing/A18: U14.13, U16.22 (CE), U17.31 (A18/TOUT)
/CPU/CLK: CX3.1, R12.2, U17.3 (EXTAL), U44.12
/CPU/D0: P3.36, U6.18 (D7), U16.13 (D0), U17.34 (D0), U43.6 (DB0), U50.61 (IO), U62.13 (DQ0), U404.2 (A0)
/CPU/D1: P3.35, U6.3 (D0), U16.14 (D1), U17.35 (D1), U43.7 (DB1), U50.64 (IO), U62.14 (DQ1), U404.3 (A1)
/CPU/D2: P3.34, U6.17 (D6), U16.15 (D2), U17.36 (D2), U43.8 (DB2), U50.67 (IO), U62.15 (DQ2), U404.4 (A2)
/CPU/D3: P3.32, U6.4 (D1), U16.17 (D3), U17.37 (D3), U43.9 (DB3), U50.69 (IO), U62.17 (DQ3), U404.5 (A3)
/CPU/D4: P3.33, U6.14 (D5), U16.18 (D4), U17.38 (D4), U43.10 (DB4), U50.73 (IO), U62.18 (DQ4), U404.6 (A4)
/CPU/D5: P3.31, U6.7 (D2), U16.19 (D5), U17.39 (D5), U43.11 (DB5), U50.75 (IO), U62.19 (DQ5), U404.7 (A5)
/CPU/D6: P3.30, U6.13 (D4), U16.20 (D6), U17.40 (D6), U43.12 (DB6), U50.77 (IO), U62.20 (DQ6), U404.8 (A6)
/CPU/D7: P3.29, U6.8 (D3), U16.21 (D7), U17.41 (D7), U43.13 (DB7), U50.80 (IO), U62.21 (DQ7), U404.9 (A7)
/CPU/~CLK: U14.15, U44.7, U44.8
/EPM7128/IO0: U30.11 (Q0), U50.63 (IO)
/EPM7128/IO1: U30.12 (Q1), U50.65 (IO)
/EPM7128/IO2: U30.13 (Q2), U50.68 (IO)
/EPM7128/IO3: U30.15 (Q3), U50.70 (IO)
/EPM7128/IO4: U30.16 (Q4), U50.74 (IO)
/EPM7128/IO5: U30.17 (Q5), U50.76 (IO)
/EPM7128/IO6: U30.18 (Q6), U50.79 (IO)
/EPM7128/IO7: U30.19 (Q7), U50.81 (IO)
/EPM7128/VA0: U30.10 (A0), U50.44 (IO)
/EPM7128/VA1: U30.9 (A1), U50.40 (IO)
/EPM7128/VA2: U30.8 (A2), U50.37 (IO)
/EPM7128/VA3: U30.7 (A3), U50.35 (IO)
/EPM7128/VA4: U30.6 (A4), U50.33 (IO)
/EPM7128/VA5: U30.5 (A5), U50.30 (IO)
/EPM7128/VA6: U30.4 (A6), U50.28 (IO)
/EPM7128/VA7: U30.3 (A7), U50.25 (IO)
/EPM7128/VA8: U30.25 (A8), U50.22 (IO)
/EPM7128/VA9: U30.24 (A9), U50.20 (IO)
/EPM7128/VA10: U30.21 (A10), U50.17 (IO)
/EPM7128/VA11: U30.23 (A11), U50.15 (IO)
/EPM7128/VA12: U30.2 (A12), U50.11 (IO)
/EPM7128/VA13: U30.26 (A13), U50.9 (IO)
/EPM7128/VA14: U30.1 (A14), U50.6 (IO)
/Expansion/BD0: P401.17, U404.18 (B0)
/Expansion/BD1: P401.15, U404.17 (B1)
/Expansion/BD2: P401.13, U404.16 (B2)
/Expansion/BD3: P401.11, U404.15 (B3)
/Expansion/BD4: P401.9, U404.14 (B4)
/Expansion/BD5: P401.7, U404.13 (B5)
/Expansion/BD6: P401.5, U404.12 (B6)
/Expansion/BD7: P401.3, U404.11 (B7)
/Video/OFFSETC: C6.1, Q1.3 (E), R14.2
CKS: P11.2, U17.53 (CKS)
CLK8: U43.22 (CLK), U44.18
CPLDCLK: CX4.1, JMP17.2 (B), R18.2, U14.5, U50.83 (GCLK)
E: P3.9, U17.60 (E)
EXPSEL_O: P3.12, U51.14 (I/O)
FDCDMA_0: U43.15 (~DACK), U51.13 (I/O)
FDCSEL_0: U43.4 (~CS), U51.12 (I/O)
FI: P3.6, U17.64 (Ø), U25.11 (C), U402.12
GND: C1.2, C2.2, C3.2, C4.2, C5.2, C7.2, C8.2, C9.2, C14.2, C15.2, C16.2, C19.2, C20.2, C23.2, C24.2, C25.2, C30.2, C31.2, C36.2, C41.2, C42.2, C43.2, C44.2, C48.2, C49.2, C50.2, C51.2, C53.2, C57.1, C61.1, C62.2, CX3.2, CX4.2, D2.1 (K), H3.1, J1.18, J1.19, J1.20, J1.21, J1.22, J1.23, J1.24, J1.25, J2.2, J2.10, J3.1, J4.4, J5.4, J6.0 (PAD), J6.5, J7.0 (PAD), J7.1, J7.2, JMP1.3, JMP2.1, JMP2.5, JMP4.2, JMP11.2, JMP13.3, P3.3, P3.4, P3.37, P3.38, P4.3, P4.5, P4.7, P4.9, P4.11, P4.13, P4.15, P4.17, P4.19, P4.21, P4.23, P4.25, P4.27, P4.29, P4.31, P4.33, P5.2, P7.2, P7.3, P8.2 (Ext), P9.3, P10.2, P10.3, P11.6, P401.2, P401.19, P401.22, P401.24, P401.26, P401.30, P401.40, Q1.1 (C), R13.2, R15.2, R17.2, T2.1, U6.1 (OE), U6.10 (GND), U8.15 (GND), U9.10 (T2IN), U9.15 (GND), U14.1, U14.10 (GND), U14.11, U14.19, U15.7 (GND), U16.16 (GND), U17.1 (Vss), U17.33 (Vss), U25.7 (GND), U30.14 (GND), U30.20 (~CS), U30.22 (~OE), U32.1 (E), U32.8 (GND), U33.7 (GND), U34.7 (GND), U35.2 (I0a), U35.5 (I0b), U35.8 (GND), U35.15 (E), U43.20 (VSS), U43.24 (P0), U43.31 (P1), U43.32 (P2), U44.1, U44.10 (GND), U44.19, U50.7 (GND), U50.19 (GND), U50.32 (GND), U50.42 (GND), U50.47 (GND), U50.59 (GND), U50.72 (GND), U50.82 (GND), U51.10 (GND), U62.16 (VSS), U402.5, U402.7 (GND), U404.10 (GND), X1.4 (GND), X2.4 (GND)
INVERT: JMP11.1, R19.1, U50.2 (OE2n)
J_CTS: J6.8, U8.8 (R2IN)
J_DCD: J6.1, U9.8 (R2IN)
J_RTS: J6.4, J6.7, U8.7 (T2OUT)
J_RX: J6.2, U8.13 (R1IN)
J_TX: J6.3, U8.14 (T1OUT)
K_RX: J3.2, U9.13 (R1IN)
K_TX: J3.3, U9.14 (T1OUT)
unnamed: C6.2, R15.1, R16.1
unnamed: C7.1, U14.16, U14.17
unnamed: C3.1, C4.1, D1.2 (A), R8.2, T2.2, U14.4
unnamed: D2.2 (A), R20.2
unnamed: D401.1 (K), R404.1
unnamed: J1.10, R6.2
unnamed: J3.4, J3.5, JMP5.2
unnamed: JMP9.1, P3.40
unnamed: JMP13.2, U16.1 (A18)
unnamed: JMP14.2, U16.30 (A17)
unnamed: JMP15.2, U16.31 (PGM)
unnamed: J7.7, JMP16.2
unnamed: JMP17.1 (A), P9.6
unnamed: P401.23, U402.6
unnamed: P401.25, U402.8
unnamed: P401.29, R403.2
unnamed: P401.34, R401.2
unnamed: P401.38, R402.2
unnamed: P401.39, R404.2
unnamed: Q1.2 (B), R9.1, R10.1, R11.1, R13.1
unnamed: J1.2, RP1.2 (R1), U6.19 (O7)
unnamed: J1.3, RP1.3 (R2), U6.2 (O0)
unnamed: J1.4, RP1.4 (R3), U6.16 (O6)
unnamed: J1.5, RP1.5 (R4), U6.5 (O1)
unnamed: J1.6, RP1.6 (R5), U6.15 (O5)
unnamed: J1.7, RP1.7 (R6), U6.6 (O2)
unnamed: J1.8, RP1.8 (R7), U6.12 (O4)
unnamed: J1.9, RP1.9 (R8), U6.9 (O3)
unnamed: RP3.4 (R3), U35.13 (I1c)
unnamed: RP3.6 (R5), U35.11 (I0d)
unnamed: C54.1, U8.1 (C1+)
unnamed: C54.2, U8.3 (C1-)
unnamed: C55.1, U8.4 (C2+)
unnamed: C55.2, U8.5 (C2-)
unnamed: C56.1, U8.2 (VS+)
unnamed: C57.2, U8.6 (VS-)
unnamed: C58.1, U9.1 (C1+)
unnamed: C58.2, U9.3 (C1-)
unnamed: C59.1, U9.4 (C2+)
unnamed: C59.2, U9.5 (C2-)
unnamed: C60.1, U9.2 (VS+)
unnamed: C61.2, U9.6 (VS-)
unnamed: J1.1, R2.2, U15.6 (~Q)
unnamed: C5.1, R5.2, R6.1, U15.11 (C)
unnamed: U25.2 (D), U25.6 (~Q)
unnamed: U25.1 (~R), U43.14 (DRQ)
unnamed: U25.9 (Q), U402.10
unnamed: U25.13 (~R), U402.11
unnamed: U32.2 (A0), U43.29 (DS0)
unnamed: U32.3 (A1), U43.28 (DS1)
unnamed: U32.4 (O0), U33.1
unnamed: U32.5 (O1), U33.13
unnamed: U32.6 (O2), U33.3
unnamed: U32.7 (O3), U33.5
unnamed: U35.3 (I1a), U43.38 (LCT_DIR)
unnamed: U35.6 (I1b), U43.37 (STEP)
unnamed: U35.1 (S), U43.39 (~RW_SEEK)
unnamed: U33.11, U35.4 (Za)
unnamed: U33.9, U35.7 (Zb)
unnamed: U35.12 (Zc), U43.34 (WP/TS)
unnamed: U35.9 (Zd), U43.33 (FLT/TR0)
unnamed: U34.5, U43.36 (HDL)
unnamed: U43.17 (IDX), U44.9
unnamed: U43.18 (INT), U44.6
unnamed: U43.35 (RDY), U44.5
unnamed: U34.9, U43.27 (SIDE)
unnamed: U14.18, U43.16 (TC)
unnamed: U34.1, U43.30 (WDOUT)
unnamed: U34.3, U43.25 (WE)
unnamed: U43.23 (~DSKD), U44.16
unnamed: U44.3, U44.4
unnamed: U14.7, U62.22 (CE#)
unnamed: U402.3, U402.4
unnamed: U44.13, X1.5 (OUT)
unnamed: U44.2, X2.5 (OUT)
OUT_B: J7.5, P9.11, U50.55 (IO)
OUT_G: J7.4, P9.9, U50.52 (IO)
OUT_I: J7.6, P9.4, U50.57 (IO)
OUT_R: J7.3, P9.7, U50.50 (IO)
PRINT_O: U6.11 (Cp), U15.3 (C), U15.13 (~R), U51.15 (I/O)
RESET: P3.28, U14.12, U43.1 (RST)
RX0: J4.3, U8.12 (R1OUT), U17.46 (RXA0)
RX1: J5.3, U9.12 (R1OUT), U17.49 (RXA1)
RXS/~CTS1: JMP2.2, P11.4, R21.2, U17.52 (RXS/~CTS1)
ST: P3.17, U17.12 (ST)
TCK: J2.1, R17.1, U50.62 (IO)
TDI: J2.9, U50.14 (IO)
TDO: J2.3, U50.71 (IO)
TMS: J2.5, U50.23 (IO)
TX0: J4.2, U8.11 (T1IN), U17.45 (TXA0)
TX1: J5.2, U9.11 (T1IN), U17.48 (TXA1)
TXS: P11.3, U17.51 (TXS), U34.13
VID1: R10.2, U50.46 (IO)
VID2: R9.2, U50.48 (IO)
X_CTS: JMP1.1, U8.9 (R2OUT)
X_DCD: JMP2.3, U9.9 (R2OUT)
fDIR: P4.18, U33.10
fDRIVE0: P4.10, U33.2
fDRIVE1: P4.12, U33.12
fDRIVE2: P4.14, U33.4
fDRIVE3: P4.6, U33.6
fINDEX: P4.8, RP3.2 (R1), U44.11
fINUSE: P4.4, U34.6
fMOTOR1: P4.16, U34.12
fREAD: P4.30, RP3.5 (R4), U44.17
fREADY: JMP4.1, P4.34, RP3.8 (R7), U44.15
fSIDE1: P4.32, U34.8
fSTEP: P4.20, U33.8
fTRACK0: P4.26, RP3.7 (R6), U35.10 (I1d)
fWDATA: P4.22, U34.2
fWGATE: P4.24, U34.4
fWRITEPROT: P4.28, RP3.3 (R2), U35.14 (I0c)
~BUSACK: RP2.4 (R3), U17.5 (~BUSACK)
~BUSREQ: RP2.5 (R4), U17.6 (~BUSREQ)
~COMP: JMP16.1, P8.1 (In), R16.2
~CSYNC: JMP16.3, R11.2, U50.49 (IO)
~CTS0: JMP1.2, U17.43 (~CTS0)
~DCD0: JMP2.4, U17.44 (~DCD0)
~DREQ0: P3.25, R4.2, U17.47 (CKA0/~DREQ0)
~DREQ1: U17.54 (~DREQ1), U25.5 (Q)
~HALT: P3.16, U17.56 (~HALT)
~HSYNC: J7.8, P9.8, U50.51 (IO)
~IDE_CS: P401.37, U51.16 (I/O), U402.1, U404.19 (CE)
~INT0: P3.15, RP2.8 (R7), U17.9 (~INT0)
~INT1: U15.8 (~Q), U17.10 (~INT1)
~INT2: U17.11 (~INT2), U44.14
~IOE: P3.26, U17.58 (~IOE), U50.4 (IO), U51.7 (I6)
~LIR: P3.10, U17.61 (~LIR)
~ME: U16.24 (OE), U17.59 (~ME), U62.24 (OE#)
~NMI: P3.11, RP2.7 (R6), U17.8 (~NMI)
~RD: P3.5, U17.63 (~RD), U25.12 (D), U43.2 (~RD), U50.58 (IO), U402.9, U402.13, U404.1 (A->B)
~REF: U17.57 (~REF), U25.3 (C)
~RESET: P3.8, P401.1, RP2.6 (R5), U14.3, U14.8, U15.1 (~R), U17.7 (~RESET), U50.1 (GCLRn)
~RTS0: U8.10 (T2IN), U17.42 (~RTS0)
~SD_CS: P11.1, U51.19 (I/O)
~TEND0: P3.21, U17.50 (CKA1/~TEND0)
~TEND1: U14.2, U17.55 (~TEND1)
~VSYNC: J7.9, P9.10, U50.54 (IO)
~VWR: U30.27 (~WE), U50.56 (IO)
~WAIT: P3.13, RP2.3 (R2), U17.4 (~WAIT)
~WR: JMP15.3, P3.7, U17.62 (~WR), U43.3 (~WR), U50.60 (IO), U62.29 (WE#), U402.2
