Board-Folk/TIM011B2/Releases/v2.2/cpld/tim011video/timvideo.qsf

# -------------------------------------------------------------------------- #
#
# Copyright (C) 1991-2013 Altera Corporation
# Your use of Altera Corporation's design tools, logic functions 
# and other software and tools, and its AMPP partner logic 
# functions, and any output files from any of the foregoing 
# (including device programming or simulation files), and any 
# associated documentation or information are expressly subject 
# to the terms and conditions of the Altera Program License 
# Subscription Agreement, Altera MegaCore Function License 
# Agreement, or other applicable license agreement, including, 
# without limitation, that your use is for the sole purpose of 
# programming logic devices manufactured by Altera and sold by 
# Altera or its authorized distributors.  Please refer to the 
# applicable agreement for further details.
#
# -------------------------------------------------------------------------- #
#
# Quartus II 64-Bit
# Version 13.0.1 Build 232 06/12/2013 Service Pack 1 SJ Web Edition
# Date created = 11:33:50  February 03, 2026
#
# -------------------------------------------------------------------------- #
#
# Notes:
#
# 1) The default values for assignments are stored in the file:
#		timvideo_assignment_defaults.qdf
#    If this file doesn't exist, see file:
#		assignment_defaults.qdf
#
# 2) Altera recommends that you do not modify this file. This
#    file is updated automatically by the Quartus II software
#    and any changes you make may be lost or overwritten.
#
# -------------------------------------------------------------------------- #


set_global_assignment -name FAMILY MAX7000S
set_global_assignment -name DEVICE "EPM7128SLC84-15"
set_global_assignment -name TOP_LEVEL_ENTITY timvideo
set_global_assignment -name ORIGINAL_QUARTUS_VERSION "13.0 SP1"
set_global_assignment -name PROJECT_CREATION_TIME_DATE "11:33:50  FEBRUARY 03, 2026"
set_global_assignment -name LAST_QUARTUS_VERSION "13.0 SP1"
set_global_assignment -name PROJECT_OUTPUT_DIRECTORY output_files
set_global_assignment -name ERROR_CHECK_FREQUENCY_DIVISOR "-1"
set_global_assignment -name MAX7000_DEVICE_IO_STANDARD TTL
set_global_assignment -name BDF_FILE timvideo.bdf
set_global_assignment -name QIP_FILE hcount.qip
set_global_assignment -name QIP_FILE vcount.qip
set_global_assignment -name QIP_FILE addrmux.qip
set_global_assignment -name QIP_FILE scradd.qip
set_location_assignment PIN_83 -to CLK
set_location_assignment PIN_6 -to VA[14]
set_location_assignment PIN_9 -to VA[13]
set_location_assignment PIN_11 -to VA[12]
set_location_assignment PIN_15 -to VA[11]
set_location_assignment PIN_17 -to VA[10]
set_location_assignment PIN_20 -to VA[9]
set_location_assignment PIN_22 -to VA[8]
set_location_assignment PIN_25 -to VA[7]
set_location_assignment PIN_28 -to VA[6]
set_location_assignment PIN_30 -to VA[5]
set_location_assignment PIN_33 -to VA[4]
set_location_assignment PIN_35 -to VA[3]
set_location_assignment PIN_37 -to VA[2]
set_location_assignment PIN_40 -to VA[1]
set_location_assignment PIN_44 -to VA[0]
set_location_assignment PIN_45 -to A[0]
set_location_assignment PIN_41 -to A[1]
set_location_assignment PIN_39 -to A[2]
set_location_assignment PIN_36 -to A[3]
set_location_assignment PIN_34 -to A[4]
set_location_assignment PIN_31 -to A[5]
set_location_assignment PIN_29 -to A[6]
set_location_assignment PIN_27 -to A[7]
set_location_assignment PIN_24 -to A[8]
set_location_assignment PIN_21 -to A[9]
set_location_assignment PIN_18 -to A[10]
set_location_assignment PIN_16 -to A[11]
set_location_assignment PIN_12 -to A[12]
set_location_assignment PIN_10 -to A[13]
set_location_assignment PIN_8 -to A[14]
set_location_assignment PIN_5 -to A[15]
set_location_assignment PIN_80 -to D[7]
set_location_assignment PIN_77 -to D[6]
set_location_assignment PIN_75 -to D[5]
set_location_assignment PIN_73 -to D[4]
set_location_assignment PIN_69 -to D[3]
set_location_assignment PIN_67 -to D[2]
set_location_assignment PIN_64 -to D[1]
set_location_assignment PIN_61 -to D[0]
set_location_assignment PIN_81 -to VD[7]
set_location_assignment PIN_79 -to VD[6]
set_location_assignment PIN_76 -to VD[5]
set_location_assignment PIN_74 -to VD[4]
set_location_assignment PIN_70 -to VD[3]
set_location_assignment PIN_68 -to VD[2]
set_location_assignment PIN_65 -to VD[1]
set_location_assignment PIN_63 -to VD[0]
set_location_assignment PIN_58 -to nRD
set_location_assignment PIN_60 -to nWR
set_location_assignment PIN_56 -to vWR
set_location_assignment PIN_46 -to VID1
set_location_assignment PIN_48 -to VID2
set_location_assignment PIN_49 -to CSYNC
set_location_assignment PIN_1 -to nRESET
set_global_assignment -name OPTIMIZE_HOLD_TIMING OFF
set_global_assignment -name OPTIMIZE_MULTI_CORNER_TIMING OFF
set_global_assignment -name FITTER_EFFORT "STANDARD FIT"
set_global_assignment -name SLOW_SLEW_RATE OFF
set_location_assignment PIN_4 -to nIOE
set_location_assignment PIN_51 -to HSYNC
set_location_assignment PIN_54 -to VSYNC
set_location_assignment PIN_50 -to OUT_R
set_location_assignment PIN_52 -to OUT_G
set_global_assignment -name QIP_FILE output_files/lpm_add_sub0.qip
set_location_assignment PIN_55 -to OUT_B
set_location_assignment PIN_57 -to OUT_I
set_location_assignment PIN_2 -to SYNC_SEL
